marneierencio/cockpit-2dof/docs/PLANO_DE_CORTE.md

# Plano de corte dos tubos — revisão R3

> Gerado por `ferramentas/analisar.py`. Barras comerciais de 6 m, perda de serra de 3 mm por corte e 10 mm de
> esquadrejamento em cada ponta da barra. Distribuição pelo método *first-fit decreasing*.

**Como ler:** cada linha é uma barra. Corte as peças na ordem listada e marque cada peça com o código, que é o
mesmo do desenho e da lista de materiais.

Os comprimentos são os do eixo da peça no modelo, de face a face das peças que ela encontra. Para peças com corte
em ângulo (diagonais, pernas e bielas), o comprimento é medido no eixo e o ângulo está na lista de materiais.
Recomenda-se cortar com +2 mm e ajustar na montagem (gabarito).

## Tubo 10x20

Barras de 6 m: **1** · peças: 5 · comprimento líquido: 2,95 m · aproveitamento: 49 %

| Barra | Peças (código: comprimento mm) | Usado (mm) | Sobra (mm) |
|---|---|---|---|
| 1 | B-T12: 807, BC-T16: 564, BC-T17: 564, M-T13: 538, M-T12: 480 | 2965 | 3015 |

## Tubo 20x30

Barras de 6 m: **7** · peças: 91 · comprimento líquido: 41,27 m · aproveitamento: 98 %

| Barra | Peças (código: comprimento mm) | Usado (mm) | Sobra (mm) |
|---|---|---|---|
| 1 | B-T01: 2070, B-T02: 2070, A-T10: 1770 | 5916 | 64 |
| 2 | A-T16: 763, A-T20: 723, A-T14: 663, B-T03: 660, B-T11: 660, B-T04: 640, B-T05: 640, B-T06: 640, A-T18: 549 | 5962 | 18 |
| 3 | B-T07: 640, B-T08: 640, B-T09: 640, B-T10: 640, A-T19: 638, PE-T07: 596, PE-T09: 596, A-T15: 592, A-T01: 585, PE-T06: 370 | 5964 | 16 |
| 4 | A-T02: 585, A-T03: 585, A-T04: 585, A-T05: 585, A-T06: 585, A-T07: 585, A-T08: 585, A-T09: 585, A-T11: 570, A-T12: 570, A-T21: 116 | 5966 | 14 |
| 5 | M-T04: 510, M-T08: 510, M-T09: 510, M-T10: 510, M-T11: 510, M-T24: 510, M-T25: 510, BC-T13: 440, BC-T14: 440, BC-T15: 440, PE-T05: 440, BC-T01: 437, VO-T06: 152 | 5955 | 25 |
| 6 | BC-T02: 437, A-T17: 427, PE-T10: 400, PE-T16: 392, BC-T05: 390, BC-T06: 390, BC-T07: 390, BC-T08: 390, PE-T08: 370, BC-T09: 361, BC-T11: 361, PE-T11: 360, PE-T12: 360, PE-T15: 320, M-T19: 318, PE-T01: 230 | 5941 | 39 |
| 7 | BC-T03: 300, BC-T04: 300, BC-T20: 292, BC-T18: 287, BC-T19: 287, B-T17: 281, B-T18: 281, B-T19: 281, B-T20: 281, BC-T21: 280, PE-T03: 230, PE-T13: 230, B-T13: 210, B-T14: 210, B-T15: 210, B-T16: 210, PE-T14: 210, A-T13: 205, VO-T07: 152, M-T18: 152, BC-T10: 111, BC-T12: 111, B-T21: 110, B-T22: 110, PE-T02: 90, PE-T04: 90, M-T17: 88, BC-T22: 68, BC-T23: 68 | 5819 | 161 |

## Tubo 30x50

Barras de 6 m: **3** · peças: 19 · comprimento líquido: 14,87 m · aproveitamento: 83 %

| Barra | Peças (código: comprimento mm) | Usado (mm) | Sobra (mm) |
|---|---|---|---|
| 1 | M-T01: 1785, M-T02: 1785, M-T20: 1100, M-T22: 1100 | 5779 | 201 |
| 2 | M-T21: 1035, M-T23: 1035, PO-T01: 903, VO-T01: 728, VO-T02: 728, M-T03: 540, M-T05: 510, VO-T04: 463 | 5963 | 17 |
| 3 | M-T06: 510, M-T07: 510, VO-T03: 504, M-T16: 481, VO-T05: 463, M-T15: 420, M-T14: 271 | 3177 | 2803 |

## Compra de tubos

| Perfil | Barras de 6 m | Observação |
|---|---|---|
| 10x20 | 1 (+1 de reserva recomendada) | sobras ≥ 300 mm servem para gabaritos e calços |
| 20x30 | 7 (+1 de reserva recomendada) | sobras ≥ 300 mm servem para gabaritos e calços |
| 30x50 | 3 (+1 de reserva recomendada) | sobras ≥ 300 mm servem para gabaritos e calços |
