marneierencio/cockpit-2dof/imagens/preview_config_caminhao.png

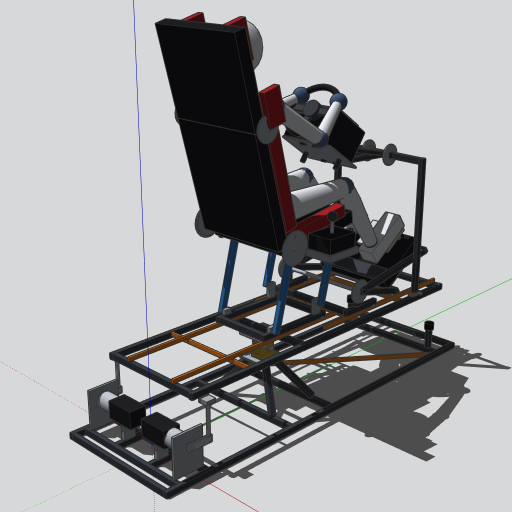
imagens/preview_config_caminhao.png
