marneierencio/cockpit-2dof/imagens/preview_config_F1.png

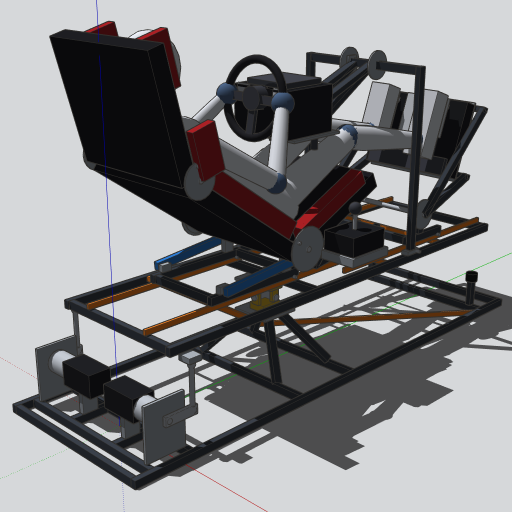
imagens/preview_config_F1.png
