marneierencio/cockpit-2dof/imagens/preview_transicao.png

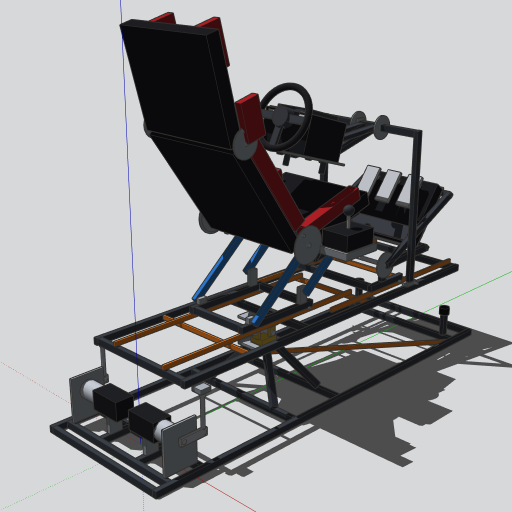
imagens/preview_transicao.png
