marneierencio/cockpit-2dof/docs/lista_de_materiais.csv

codigo | conjunto | tipo | descricao | perfil | dimensoes_mm | comprimento_corte_mm | corte | massa_kg | especificacao
B-T01 | Plataforma-base | Tubo | Longarina base E | 20x30 | 20x30 x 2070 | 2070 | reto | 1,838
B-T02 | Plataforma-base | Tubo | Longarina base D | 20x30 | 20x30 x 2070 | 2070 | reto | 1,838
B-T03 | Plataforma-base | Tubo | Travessa base y-190 | 20x30 | 20x30 x 660 | 660 | reto | 0,574
B-T04 | Plataforma-base | Tubo | Travessa base y40 | 20x30 | 20x30 x 640 | 640 | reto | 0,574
B-T05 | Plataforma-base | Tubo | Travessa base y300 | 20x30 | 20x30 x 640 | 640 | reto | 0,574
B-T06 | Plataforma-base | Tubo | Travessa base y560 | 20x30 | 20x30 x 640 | 640 | reto | 0,574
B-T07 | Plataforma-base | Tubo | Travessa base y650 | 20x30 | 20x30 x 640 | 640 | reto | 0,574
B-T08 | Plataforma-base | Tubo | Travessa base y840 | 20x30 | 20x30 x 640 | 640 | reto | 0,574
B-T09 | Plataforma-base | Tubo | Travessa base y1100 | 20x30 | 20x30 x 640 | 640 | reto | 0,574
B-T10 | Plataforma-base | Tubo | Travessa base y1700 | 20x30 | 20x30 x 640 | 640 | reto | 0,574
B-T11 | Plataforma-base | Tubo | Travessa base y1840 | 20x30 | 20x30 x 660 | 660 | reto | 0,574
B-T12 | Plataforma-base | Tubo | Diagonal base | 10x20 | 10x20 x 807 | 807 | angulo | 0,419
B-T13 | Plataforma-base | Tubo | Apoio motor E | 20x30 | 20x30 x 210 | 210 | reto | 0,188
B-T14 | Plataforma-base | Tubo | Longarina apoio chapa motor E | 20x30 | 20x30 x 210 | 210 | reto | 0,188
B-T15 | Plataforma-base | Tubo | Apoio motor D | 20x30 | 20x30 x 210 | 210 | reto | 0,188
B-T16 | Plataforma-base | Tubo | Longarina apoio chapa motor D | 20x30 | 20x30 x 210 | 210 | reto | 0,188
B-T17 | Plataforma-base | Tubo | Perna torre pivo | 20x30 | 20x30 x 281 | 281 | angulo | 0,237
B-T18 | Plataforma-base | Tubo | Perna torre pivo | 20x30 | 20x30 x 281 | 281 | angulo | 0,237
B-T19 | Plataforma-base | Tubo | Perna torre pivo | 20x30 | 20x30 x 281 | 281 | angulo | 0,237
B-T20 | Plataforma-base | Tubo | Perna torre pivo | 20x30 | 20x30 x 281 | 281 | angulo | 0,237
B-CH01 | Plataforma-base | Chapa/peça usinada | Chapa topo torre pivo 160x160x8 |  | 160 x 160 x 8 |  |  | 1,608
B-CO01 | Plataforma-base | Comprado | Garfo inferior cardan |  | 90 x 70 x 22 |  |  | 1,088 | Junta cardan (cruzeta com rolamentos de agulha), capacidade estatica >= 20 kN
B-CO02 | Plataforma-base | Comprado | Orelha garfo inferior |  | 35 x 32 x 14 |  |  | 0,123 | Junta cardan (cruzeta com rolamentos de agulha), capacidade estatica >= 20 kN
B-CO03 | Plataforma-base | Comprado | Orelha garfo inferior |  | 35 x 32 x 14 |  |  | 0,123 | Junta cardan (cruzeta com rolamentos de agulha), capacidade estatica >= 20 kN
B-CO04 | Plataforma-base | Comprado | Cruzeta eixo Y (rolagem) |  | Ø26 x 120 |  |  | 0,500 | Junta cardan (cruzeta com rolamentos de agulha), capacidade estatica >= 20 kN
B-CH02 | Plataforma-base | Chapa/peça usinada | Chapa suporte motor 6mm E |  | 177 x 120 x 6 |  |  | 1,000
B-CO05 | Plataforma-base | Comprado | Redutor planetario E |  | Ø84 x 95 |  |  | 3,000 | Redutor planetario 20:1 para NEMA 34 (flange 86 mm), torque nominal de saida >= 150 N.m
B-CO06 | Plataforma-base | Comprado | Motor de passo NEMA 34 E |  | 150 x 86 x 86 |  |  | 5,500 | Motor de passo NEMA 34 12 N.m em malha fechada (ex.: 86HSE12N) + driver
B-CH03 | Plataforma-base | Chapa/peça usinada | Calco motor E |  | 87 x 60 x 20 |  |  | 0,820
B-PI01 | Plataforma-base | Pino | Eixo saida redutor E |  | Ø20 x 23 |  |  | 0,057
B-CH04 | Plataforma-base | Chapa/peça usinada | Braco manivela 10mm E |  | 150 x 50 x 10 |  |  | 0,589
B-CO07 | Plataforma-base | Comprado | Terminal rotular inferior E |  |  |  |  | 0,072 | Terminal rotular M16 (rod end)
B-CH05 | Plataforma-base | Chapa/peça usinada | Chapa suporte motor 6mm D |  | 177 x 120 x 6 |  |  | 1,000
B-CO08 | Plataforma-base | Comprado | Redutor planetario D |  | Ø84 x 95 |  |  | 3,000 | Redutor planetario 20:1 para NEMA 34 (flange 86 mm), torque nominal de saida >= 150 N.m
B-CO09 | Plataforma-base | Comprado | Motor de passo NEMA 34 D |  | 150 x 86 x 86 |  |  | 5,500 | Motor de passo NEMA 34 12 N.m em malha fechada (ex.: 86HSE12N) + driver
B-CH06 | Plataforma-base | Chapa/peça usinada | Calco motor D |  | 87 x 60 x 20 |  |  | 0,820
B-PI02 | Plataforma-base | Pino | Eixo saida redutor D |  | Ø20 x 23 |  |  | 0,057
B-CH07 | Plataforma-base | Chapa/peça usinada | Braco manivela 10mm D |  | 150 x 50 x 10 |  |  | 0,589
B-CO10 | Plataforma-base | Comprado | Terminal rotular inferior D |  |  |  |  | 0,072 | Terminal rotular M16 (rod end)
B-T21 | Plataforma-base | Tubo | Coluna batente E | 20x30 | 20x30 x 110 | 110 | reto | 0,099
B-CO11 | Plataforma-base | Comprado | Batente borracha E |  | Ø48 x 35 |  |  | 0,100 | Batente de borracha Ø48 x 35
B-T22 | Plataforma-base | Tubo | Coluna batente D | 20x30 | 20x30 x 110 | 110 | reto | 0,099
B-CO12 | Plataforma-base | Comprado | Batente borracha D |  | Ø48 x 35 |  |  | 0,100 | Batente de borracha Ø48 x 35
M-T01 | Chassi móvel | Tubo | Longarina principal E | 30x50 | 30x50 x 1785 | 1785 | reto | 2,588
M-T02 | Chassi móvel | Tubo | Longarina principal D | 30x50 | 30x50 x 1785 | 1785 | reto | 2,588
M-T03 | Chassi móvel | Tubo | Travessa chassi y25 | 30x50 | 30x50 x 540 | 540 | reto | 0,746
M-T04 | Chassi móvel | Tubo | Travessa chassi y300 | 20x30 | 20x30 x 510 | 510 | reto | 0,457
M-T05 | Chassi móvel | Tubo | Travessa chassi y650 | 30x50 | 30x50 x 510 | 510 | reto | 0,746
M-T06 | Chassi móvel | Tubo | Travessa chassi y700 | 30x50 | 30x50 x 510 | 510 | reto | 0,746
M-T07 | Chassi móvel | Tubo | Travessa chassi y750 | 30x50 | 30x50 x 510 | 510 | reto | 0,746
M-T08 | Chassi móvel | Tubo | Travessa chassi y900 | 20x30 | 20x30 x 510 | 510 | reto | 0,457
M-T09 | Chassi móvel | Tubo | Travessa chassi y1100 | 20x30 | 20x30 x 510 | 510 | reto | 0,457
M-T10 | Chassi móvel | Tubo | Travessa chassi y1450 | 20x30 | 20x30 x 510 | 510 | reto | 0,457
M-T11 | Chassi móvel | Tubo | Travessa chassi y1765 | 20x30 | 20x30 x 510 | 510 | reto | 0,457
M-T12 | Chassi móvel | Tubo | Diagonal piso y25-300 | 10x20 | 10x20 x 480 | 480 | angulo | 0,249
M-T13 | Chassi móvel | Tubo | Diagonal piso y1100-1450 | 10x20 | 10x20 x 538 | 538 | angulo | 0,279
M-CH01 | Chassi móvel | Chapa/peça usinada | Chapa pivo 300x140x8 |  | 300 x 140 x 8 |  |  | 2,638
M-T14 | Chassi móvel | Tubo | Banzo inferior soleira E y60-300 | 30x50 | 30x50 x 271 | 271 | angulo | 0,322
M-T15 | Chassi móvel | Tubo | Banzo inferior soleira E y300-700 | 30x50 | 30x50 x 420 | 420 | angulo | 0,595
M-T16 | Chassi móvel | Tubo | Banzo inferior soleira E y700-1132 | 30x50 | 30x50 x 481 | 481 | angulo | 0,614
M-T17 | Chassi móvel | Tubo | Montante soleira E y324 | 20x30 | 20x30 x 88 | 88 | reto | 0,076
M-T18 | Chassi móvel | Tubo | Montante soleira E y670 | 20x30 | 20x30 x 152 | 152 | reto | 0,134
M-T19 | Chassi móvel | Tubo | Diagonal soleira E y324-670 | 20x30 | 20x30 x 318 | 318 | angulo | 0,285
M-CH02 | Chassi móvel | Chapa/peça usinada | Suporte haste traseira E |  | 50 x 45 x 20 |  |  | 0,353
M-CO01 | Chassi móvel | Comprado | Haste ligacao E |  | Ø16 x 124 |  |  | 0,196 | Barra rosqueada M16 + porcas (entre rotulas)
M-CO02 | Chassi móvel | Comprado | Terminal rotular superior E |  |  |  |  | 0,072 | Terminal rotular M16 (rod end)
M-CH03 | Chassi móvel | Chapa/peça usinada | Suporte haste traseira D |  | 50 x 45 x 20 |  |  | 0,353
M-CO03 | Chassi móvel | Comprado | Haste ligacao D |  | Ø16 x 124 |  |  | 0,196 | Barra rosqueada M16 + porcas (entre rotulas)
M-CO04 | Chassi móvel | Comprado | Terminal rotular superior D |  |  |  |  | 0,072 | Terminal rotular M16 (rod end)
M-CO05 | Chassi móvel | Comprado | Garfo superior cardan |  | 120 x 60 x 22 |  |  | 1,243 | Junta cardan (cruzeta com rolamentos de agulha), capacidade estatica >= 20 kN
M-CO06 | Chassi móvel | Comprado | Orelha garfo superior |  | 48 x 32 x 14 |  |  | 0,169 | Junta cardan (cruzeta com rolamentos de agulha), capacidade estatica >= 20 kN
M-CO07 | Chassi móvel | Comprado | Orelha garfo superior |  | 48 x 32 x 14 |  |  | 0,169 | Junta cardan (cruzeta com rolamentos de agulha), capacidade estatica >= 20 kN
M-CO08 | Chassi móvel | Comprado | Cruzeta eixo X (arfagem) |  | Ø26 x 120 |  |  | 0,500 | Junta cardan (cruzeta com rolamentos de agulha), capacidade estatica >= 20 kN
M-T20 | Chassi móvel | Tubo | Trilho banco E | 30x50 | 30x50 x 1100 | 1100 | reto | 1,608
M-T21 | Chassi móvel | Tubo | Trilho pedaleira E | 30x50 | 30x50 x 1035 | 1035 | reto | 1,513
M-T22 | Chassi móvel | Tubo | Trilho banco D | 30x50 | 30x50 x 1100 | 1100 | reto | 1,608
M-T23 | Chassi móvel | Tubo | Trilho pedaleira D | 30x50 | 30x50 x 1035 | 1035 | reto | 1,513
BC-T01 | Banco | Tubo | Longarina carro banco E | 20x30 | 20x30 x 437 | 437 | reto | 0,373
BC-CH01 | Banco | Chapa/peça usinada | Mancal biela tras E |  | 40 x 27 x 20 |  |  | 0,170
BC-PI01 | Banco | Pino | Pino mancal biela tras E |  | Ø16 x 30 |  |  | 0,047 | Pino aco 1045 Ø16 x 30 mm + 2 travas (anel elastico) + 2 buchas soldadas
BC-CH02 | Banco | Chapa/peça usinada | Mancal biela diant E |  | 75 x 40 x 20 |  |  | 0,474
BC-PI02 | Banco | Pino | Pino mancal biela diant E |  | Ø16 x 30 |  |  | 0,047 | Pino aco 1045 Ø16 x 30 mm + 2 travas (anel elastico) + 2 buchas soldadas
BC-PI03 | Banco | Pino | Pino indexador trilho banco E |  | Ø12 x 60 |  |  | 0,053 | Pino de trava rapida (ball lock) Ø12 x 60 mm com argola
BC-T02 | Banco | Tubo | Longarina carro banco D | 20x30 | 20x30 x 437 | 437 | reto | 0,373
BC-CH03 | Banco | Chapa/peça usinada | Mancal biela tras D |  | 40 x 27 x 20 |  |  | 0,170
BC-PI04 | Banco | Pino | Pino mancal biela tras D |  | Ø16 x 30 |  |  | 0,047 | Pino aco 1045 Ø16 x 30 mm + 2 travas (anel elastico) + 2 buchas soldadas
BC-CH04 | Banco | Chapa/peça usinada | Mancal biela diant D |  | 75 x 40 x 20 |  |  | 0,474
BC-PI05 | Banco | Pino | Pino mancal biela diant D |  | Ø16 x 30 |  |  | 0,047 | Pino aco 1045 Ø16 x 30 mm + 2 travas (anel elastico) + 2 buchas soldadas
BC-PI06 | Banco | Pino | Pino indexador trilho banco D |  | Ø12 x 60 |  |  | 0,053 | Pino de trava rapida (ball lock) Ø12 x 60 mm com argola
BC-T03 | Banco | Tubo | Travessa carro banco tras | 20x30 | 20x30 x 300 | 300 | reto | 0,251
BC-T04 | Banco | Tubo | Travessa carro banco diant | 20x30 | 20x30 x 300 | 300 | reto | 0,251
BC-T05 | Banco | Tubo | Biela banco E Tras | 20x30 | 20x30 x 390 | 390 | reto | 0,350
BC-T06 | Banco | Tubo | Biela banco D Tras | 20x30 | 20x30 x 390 | 390 | reto | 0,350
BC-T07 | Banco | Tubo | Biela banco E Diant | 20x30 | 20x30 x 390 | 390 | reto | 0,350
BC-T08 | Banco | Tubo | Biela banco D Diant | 20x30 | 20x30 x 390 | 390 | reto | 0,350
BC-T09 | Banco | Tubo | Longarina subchassi E | 20x30 | 20x30 x 361 | 361 | reto | 0,323
BC-T10 | Banco | Tubo | Montante articulacao E | 20x30 | 20x30 x 111 | 111 | angulo | 0,089
BC-PI07 | Banco | Pino | Pino biela subchassi E |  | Ø16 x 90 |  |  | 0,142 | Pino aco 1045 Ø16 x 90 mm + 2 travas (anel elastico) + 2 buchas soldadas
BC-PI08 | Banco | Pino | Pino biela subchassi E |  | Ø16 x 90 |  |  | 0,142 | Pino aco 1045 Ø16 x 90 mm + 2 travas (anel elastico) + 2 buchas soldadas
BC-T11 | Banco | Tubo | Longarina subchassi D | 20x30 | 20x30 x 361 | 361 | reto | 0,323
BC-T12 | Banco | Tubo | Montante articulacao D | 20x30 | 20x30 x 111 | 111 | angulo | 0,089
BC-PI09 | Banco | Pino | Pino biela subchassi D |  | Ø16 x 90 |  |  | 0,142 | Pino aco 1045 Ø16 x 90 mm + 2 travas (anel elastico) + 2 buchas soldadas
BC-PI10 | Banco | Pino | Pino biela subchassi D |  | Ø16 x 90 |  |  | 0,142 | Pino aco 1045 Ø16 x 90 mm + 2 travas (anel elastico) + 2 buchas soldadas
BC-PI11 | Banco | Pino | Eixo articulacao assento/encosto |  | Ø20 x 580 |  |  | 1,430 | Pino aco 1045 Ø20 x 580 mm + 2 travas (anel elastico) + 2 buchas soldadas
BC-CO01 | Banco | Comprado | Calco borracha apoio F1 tras E |  | Ø28 x 78 |  |  | 0,050 | Calco de borracha Ø28 com parafuso (apoio do subchassi em F1)
BC-CO02 | Banco | Comprado | Calco borracha apoio F1 diant E |  | Ø28 x 117 |  |  | 0,050 | Calco de borracha Ø28 com parafuso (apoio do subchassi em F1)
BC-CO03 | Banco | Comprado | Calco borracha apoio F1 tras D |  | Ø28 x 78 |  |  | 0,050 | Calco de borracha Ø28 com parafuso (apoio do subchassi em F1)
BC-CO04 | Banco | Comprado | Calco borracha apoio F1 diant D |  | Ø28 x 117 |  |  | 0,050 | Calco de borracha Ø28 com parafuso (apoio do subchassi em F1)
BC-ES01 | Banco | Estofado | Assento estofado 480x440x60 |  | 480 x 440 x 60 |  |  | 3,000 | Assento estofado sobre base de compensado/aco
BC-T13 | Banco | Tubo | Espinha assento | 20x30 | 20x30 x 440 | 440 | reto | 0,395
BC-ES02 | Banco | Estofado | Aba assento E |  | 350 x 55 x 50 |  |  | 0,400
BC-ES03 | Banco | Estofado | Aba assento D |  | 350 x 55 x 50 |  |  | 0,400
BC-ES04 | Banco | Estofado | Encosto lombar 480x563x60 |  | 563 x 480 x 60 |  |  | 3,500 | Encosto estofado sobre base de compensado/aco
BC-T14 | Banco | Tubo | Espinha encosto | 20x30 | 20x30 x 440 | 440 | reto | 0,395
BC-ES05 | Banco | Estofado | Aba encosto E |  | 463 x 65 x 50 |  |  | 0,500
BC-ES06 | Banco | Estofado | Aba encosto D |  | 463 x 65 x 50 |  |  | 0,500
BC-PI12 | Banco | Pino | Eixo articulacao apoio superior |  | Ø18 x 524 |  |  | 1,047 | Pino aco 1045 Ø18 x 524 mm + 2 travas (anel elastico) + 2 buchas soldadas
BC-ES07 | Banco | Estofado | Apoio ombros/cabeca 480x430x60 |  | 480 x 430 x 60 |  |  | 2,500 | Apoio estofado sobre base de compensado/aco
BC-T15 | Banco | Tubo | Espinha apoio superior | 20x30 | 20x30 x 440 | 440 | reto | 0,395
BC-ES08 | Banco | Estofado | Aba ombro E |  | 160 x 90 x 30 |  |  | 0,400
BC-ES09 | Banco | Estofado | Aba cabeca E |  | 180 x 100 x 30 |  |  | 0,300
BC-ES10 | Banco | Estofado | Aba ombro D |  | 160 x 90 x 30 |  |  | 0,400
BC-ES11 | Banco | Estofado | Aba cabeca D |  | 180 x 100 x 30 |  |  | 0,300
BC-T16 | Banco | Tubo | Tirante paralelo apoio superior E | 10x20 | 10x20 x 564 | 564 | reto | 0,293
BC-CH05 | Banco | Chapa/peça usinada | Orelha tirante subchassi E |  | 52 x 27 x 8 |  |  | 0,089
BC-CH06 | Banco | Chapa/peça usinada | Orelha tirante apoio E |  | 40 x 30 x 8 |  |  | 0,075
BC-PI13 | Banco | Pino | Pino tirante inferior E |  | Ø12 x 24 |  |  | 0,021 | Pino aco 1045 Ø12 x 24 mm + 2 travas (anel elastico) + 2 buchas soldadas
BC-PI14 | Banco | Pino | Pino tirante superior E |  | Ø12 x 24 |  |  | 0,021 | Pino aco 1045 Ø12 x 24 mm + 2 travas (anel elastico) + 2 buchas soldadas
BC-T17 | Banco | Tubo | Tirante paralelo apoio superior D | 10x20 | 10x20 x 564 | 564 | reto | 0,293
BC-CH07 | Banco | Chapa/peça usinada | Orelha tirante subchassi D |  | 52 x 27 x 8 |  |  | 0,089
BC-CH08 | Banco | Chapa/peça usinada | Orelha tirante apoio D |  | 40 x 30 x 8 |  |  | 0,075
BC-PI15 | Banco | Pino | Pino tirante inferior D |  | Ø12 x 24 |  |  | 0,021 | Pino aco 1045 Ø12 x 24 mm + 2 travas (anel elastico) + 2 buchas soldadas
BC-PI16 | Banco | Pino | Pino tirante superior D |  | Ø12 x 24 |  |  | 0,021 | Pino aco 1045 Ø12 x 24 mm + 2 travas (anel elastico) + 2 buchas soldadas
BC-CH09 | Banco | Chapa/peça usinada | Alavanca encosto E (chapa 12x70) |  | 175 x 70 x 12 |  |  | 1,154
BC-T18 | Banco | Tubo | Haste comando encosto E | 20x30 | 20x30 x 287 | 287 | reto | 0,257
BC-CH10 | Banco | Chapa/peça usinada | Suporte haste encosto E |  | 40 x 30 x 12 |  |  | 0,115
BC-CH11 | Banco | Chapa/peça usinada | Alavanca encosto D (chapa 12x70) |  | 175 x 70 x 12 |  |  | 1,154
BC-T19 | Banco | Tubo | Haste comando encosto D | 20x30 | 20x30 x 287 | 287 | reto | 0,257
BC-CH12 | Banco | Chapa/peça usinada | Suporte haste encosto D |  | 40 x 30 x 12 |  |  | 0,115
BC-CH13 | Banco | Chapa/peça usinada | Orelha haste assento (chapa 12) |  | 95 x 70 x 12 |  |  | 0,626
BC-T20 | Banco | Tubo | Haste comando assento | 20x30 | 20x30 x 292 | 292 | reto | 0,261
BC-CH14 | Banco | Chapa/peça usinada | Suporte haste assento |  | 40 x 37 x 12 |  |  | 0,140
BC-T21 | Banco | Tubo | Travessa carro banco haste encosto | 20x30 | 20x30 x 280 | 280 | reto | 0,251
M-T24 | Chassi móvel | Tubo | Travessa suporte tirante arrasto | 20x30 | 20x30 x 510 | 510 | reto | 0,457
BC-T22 | Banco | Tubo | Tirante de arrasto do carro E | 20x30 | 20x30 x 68 | 68 | reto | 0,061
BC-CH15 | Banco | Chapa/peça usinada | Suporte tirante arrasto E |  | 128 x 24 x 20 |  |  | 0,481
BC-PI17 | Banco | Pino | Pino tirante arrasto na biela E |  | Ø12 x 24 |  |  | 0,021 | Pino aco 1045 Ø12 x 24 mm + 2 travas (anel elastico) + 2 buchas soldadas
BC-T23 | Banco | Tubo | Tirante de arrasto do carro D | 20x30 | 20x30 x 68 | 68 | reto | 0,061
BC-CH16 | Banco | Chapa/peça usinada | Suporte tirante arrasto D |  | 128 x 24 x 20 |  |  | 0,481
BC-PI18 | Banco | Pino | Pino tirante arrasto na biela D |  | Ø12 x 24 |  |  | 0,021 | Pino aco 1045 Ø12 x 24 mm + 2 travas (anel elastico) + 2 buchas soldadas
PE-T01 | Pedaleira | Tubo | Longarina carro pedaleira E | 20x30 | 20x30 x 230 | 230 | reto | 0,206
PE-T02 | Pedaleira | Tubo | Torre pivo pedaleira E | 20x30 | 20x30 x 90 | 90 | reto | 0,081
PE-PI01 | Pedaleira | Pino | Pino indexador trilho pedaleira E |  | Ø12 x 60 |  |  | 0,053 | Pino de trava rapida (ball lock) Ø12 x 60 mm com argola
PE-T03 | Pedaleira | Tubo | Longarina carro pedaleira D | 20x30 | 20x30 x 230 | 230 | reto | 0,206
PE-T04 | Pedaleira | Tubo | Torre pivo pedaleira D | 20x30 | 20x30 x 90 | 90 | reto | 0,081
PE-PI02 | Pedaleira | Pino | Pino indexador trilho pedaleira D |  | Ø12 x 60 |  |  | 0,053 | Pino de trava rapida (ball lock) Ø12 x 60 mm com argola
PE-T05 | Pedaleira | Tubo | Travessa carro pedaleira | 20x30 | 20x30 x 440 | 440 | reto | 0,395
PE-PI03 | Pedaleira | Pino | Eixo pivo pedaleira |  | Ø18 x 490 |  |  | 0,979 | Pino aco 1045 Ø18 x 490 mm + 2 travas (anel elastico) + 2 buchas soldadas
PE-CH01 | Pedaleira | Chapa/peça usinada | Chapa fixacao pedais 400x331x2 |  | 400 x 331 x 2 |  |  | 2,079
PE-CO01 | Pedaleira | Comprado | Pedais G920 (carcaca) |  | 428 x 311 x 55 |  |  | 2,400 | Logitech G920 - pedais (428,5 x 311 x 167 mm, 3,1 kg)
PE-CO02 | Pedaleira | Comprado | Pedais G920 (apoio calcanhar) |  | 380 x 70 x 20 |  |  | 0,100 | Logitech G920 - pedais (428,5 x 311 x 167 mm, 3,1 kg)
PE-CO03 | Pedaleira | Comprado | Pedais G920 (pedal embreagem) |  | 160 x 74 x 16 |  |  | 0,200 | Logitech G920 - pedais (428,5 x 311 x 167 mm, 3,1 kg)
PE-CO04 | Pedaleira | Comprado | Pedais G920 (pedal freio) |  | 160 x 74 x 16 |  |  | 0,200 | Logitech G920 - pedais (428,5 x 311 x 167 mm, 3,1 kg)
PE-CO05 | Pedaleira | Comprado | Pedais G920 (pedal acelerador) |  | 160 x 74 x 16 |  |  | 0,200 | Logitech G920 - pedais (428,5 x 311 x 167 mm, 3,1 kg)
PE-T06 | Pedaleira | Tubo | Braco pedaleira inferior E | 20x30 | 20x30 x 370 | 370 | angulo | 0,253
PE-T07 | Pedaleira | Tubo | Braco pedaleira superior E | 20x30 | 20x30 x 596 | 596 | angulo | 0,471
PE-T08 | Pedaleira | Tubo | Braco pedaleira inferior D | 20x30 | 20x30 x 370 | 370 | angulo | 0,253
PE-T09 | Pedaleira | Tubo | Braco pedaleira superior D | 20x30 | 20x30 x 596 | 596 | angulo | 0,471
PE-T10 | Pedaleira | Tubo | Travessa pedaleira inferior | 20x30 | 20x30 x 400 | 400 | reto | 0,359
PE-T11 | Pedaleira | Tubo | Travessa pedaleira superior | 20x30 | 20x30 x 360 | 360 | reto | 0,323
PE-T12 | Pedaleira | Tubo | Tubo de torcao pedaleira | 20x30 | 20x30 x 360 | 360 | reto | 0,323
PE-T13 | Pedaleira | Tubo | Alavanca haste pedaleira | 20x30 | 20x30 x 230 | 230 | reto | 0,206
PE-T14 | Pedaleira | Tubo | Haste comando pedaleira | 20x30 | 20x30 x 210 | 210 | reto | 0,188
PE-PI04 | Pedaleira | Pino | Pino haste/alavanca pedaleira |  | Ø16 x 50 |  |  | 0,079 | Pino aco 1045 Ø16 x 50 mm + 2 travas (anel elastico) + 2 buchas soldadas
PE-T15 | Pedaleira | Tubo | Poste suporte haste pedaleira | 20x30 | 20x30 x 320 | 320 | reto | 0,287
PE-PI05 | Pedaleira | Pino | Pino haste pedaleira no poste |  | Ø16 x 48 |  |  | 0,076 | Pino aco 1045 Ø16 x 48 mm + 2 travas (anel elastico) + 2 buchas soldadas
PE-T16 | Pedaleira | Tubo | Mao-francesa poste haste pedaleira | 20x30 | 20x30 x 392 | 392 | angulo | 0,324
M-T25 | Chassi móvel | Tubo | Travessa suporte haste pedaleira | 20x30 | 20x30 x 510 | 510 | reto | 0,457
VO-CH01 | Volante | Chapa/peça usinada | Patim trilho mastro E |  | 80 x 30 x 12 |  |  | 0,226
VO-T01 | Volante | Tubo | Coluna volante E | 30x50 | 30x50 x 728 | 728 | reto | 1,064
VO-CH02 | Volante | Chapa/peça usinada | Guia superior coluna/anel E |  | 80 x 50 x 6 |  |  | 0,188
VO-CH03 | Volante | Chapa/peça usinada | Guia inferior coluna/anel E |  | 80 x 50 x 6 |  |  | 0,188
VO-PI01 | Volante | Pino | Pino indexador mastro E |  | Ø12 x 24 |  |  | 0,021 | Pino de trava rapida (ball lock) Ø12 x 24 mm com argola
VO-CO01 | Volante | Comprado | Mancal tubo torcao E |  | Ø60 x 30 |  |  | 0,400 | Mancal flangeado para eixo Ø25
VO-CH04 | Volante | Chapa/peça usinada | Patim trilho mastro D |  | 80 x 30 x 12 |  |  | 0,226
VO-T02 | Volante | Tubo | Coluna volante D | 30x50 | 30x50 x 728 | 728 | reto | 1,064
VO-CH05 | Volante | Chapa/peça usinada | Guia superior coluna/anel D |  | 80 x 50 x 6 |  |  | 0,188
VO-CH06 | Volante | Chapa/peça usinada | Guia inferior coluna/anel D |  | 80 x 50 x 6 |  |  | 0,188
VO-PI02 | Volante | Pino | Pino indexador mastro D |  | Ø12 x 24 |  |  | 0,021 | Pino de trava rapida (ball lock) Ø12 x 24 mm com argola
VO-CO02 | Volante | Comprado | Mancal tubo torcao D |  | Ø60 x 30 |  |  | 0,400 | Mancal flangeado para eixo Ø25
VO-T03 | Volante | Tubo | Tubo de torcao volante | 30x50 | 30x50 x 504 | 504 | reto | 0,737
VO-PI03 | Volante | Pino | Eixo pivo volante |  | Ø25 x 600 |  |  | 2,312
VO-CH07 | Volante | Chapa/peça usinada | Mesa volante 300x240x3 |  | 300 x 240 x 3 |  |  | 1,696
VO-CO03 | Volante | Comprado | Volante G920 (base) |  | 260 x 232 x 170 |  |  | 1,600 | Logitech G920 - volante (270 x 260 x 278 mm, 2,25 kg)
VO-CO04 | Volante | Comprado | Volante G920 (tampa) |  | 190 x 180 x 20 |  |  | 0,050 | Logitech G920 - volante (270 x 260 x 278 mm, 2,25 kg)
VO-CO05 | Volante | Comprado | Volante G920 (aro) |  |  |  |  | 0,500 | Logitech G920 - volante (270 x 260 x 278 mm, 2,25 kg)
VO-CO06 | Volante | Comprado | Volante G920 (cubo) |  | Ø84 x 58 |  |  | 0,100 | Logitech G920 - volante (270 x 260 x 278 mm, 2,25 kg)
VO-T04 | Volante | Tubo | Braco volante E | 30x50 | 30x50 x 463 | 463 | angulo | 0,667
VO-T05 | Volante | Tubo | Braco volante D | 30x50 | 30x50 x 463 | 463 | angulo | 0,667
VO-T06 | Volante | Tubo | Alavanca came volante E | 20x30 | 20x30 x 152 | 152 | reto | 0,136
VO-PI04 | Volante | Pino | Pino seguidor came volante E |  | Ø12 x 24 |  |  | 0,021 | Pino aco 1045 Ø12 x 24 mm + 2 travas (anel elastico) + 2 buchas soldadas
VO-CH08 | Volante | Chapa/peça usinada | Chapa came volante 4mm E |  | 235 x 140 x 4 |  |  | 1,036
VO-T07 | Volante | Tubo | Alavanca came volante D | 20x30 | 20x30 x 152 | 152 | reto | 0,136
VO-PI05 | Volante | Pino | Pino seguidor came volante D |  | Ø12 x 24 |  |  | 0,021 | Pino aco 1045 Ø12 x 24 mm + 2 travas (anel elastico) + 2 buchas soldadas
VO-CH09 | Volante | Chapa/peça usinada | Chapa came volante 4mm D |  | 235 x 140 x 4 |  |  | 1,036
A-T01 | Anel estrutural | Tubo | Coluna anel D y25 | 20x30 | 20x30 x 585 | 585 | reto | 0,525
A-T02 | Anel estrutural | Tubo | Coluna anel D y400 | 20x30 | 20x30 x 585 | 585 | reto | 0,525
A-T03 | Anel estrutural | Tubo | Coluna anel D y1000 | 20x30 | 20x30 x 585 | 585 | reto | 0,525
A-T04 | Anel estrutural | Tubo | Coluna anel D y1765 | 20x30 | 20x30 x 585 | 585 | reto | 0,525
A-T05 | Anel estrutural | Tubo | Coluna anel E y25 | 20x30 | 20x30 x 585 | 585 | reto | 0,525
A-T06 | Anel estrutural | Tubo | Coluna anel E y200 | 20x30 | 20x30 x 585 | 585 | reto | 0,525
A-T07 | Anel estrutural | Tubo | Coluna anel E y1132 | 20x30 | 20x30 x 585 | 585 | reto | 0,525
A-T08 | Anel estrutural | Tubo | Coluna anel E y1450 | 20x30 | 20x30 x 585 | 585 | reto | 0,525
A-T09 | Anel estrutural | Tubo | Coluna anel E y1765 | 20x30 | 20x30 x 585 | 585 | reto | 0,525
A-T10 | Anel estrutural | Tubo | Anel lado D | 20x30 | 20x30 x 1770 | 1770 | reto | 1,587
A-T11 | Anel estrutural | Tubo | Travessa traseira rebaixada | 20x30 | 20x30 x 570 | 570 | reto | 0,511
A-T12 | Anel estrutural | Tubo | Anel dianteiro | 20x30 | 20x30 x 570 | 570 | reto | 0,511
A-T13 | Anel estrutural | Tubo | Anel lado E traseiro | 20x30 | 20x30 x 205 | 205 | reto | 0,184
A-T14 | Anel estrutural | Tubo | Anel lado E dianteiro | 20x30 | 20x30 x 663 | 663 | reto | 0,594
A-T15 | Anel estrutural | Tubo | Diagonal anel D y25-400 | 20x30 | 20x30 x 592 | 592 | angulo | 0,530
A-T16 | Anel estrutural | Tubo | Diagonal anel D y400-1000 | 20x30 | 20x30 x 763 | 763 | angulo | 0,684
A-T17 | Anel estrutural | Tubo | Diagonal anel E y25-200 | 20x30 | 20x30 x 427 | 427 | angulo | 0,383
A-T18 | Anel estrutural | Tubo | Diagonal anel E y1132-1450 | 20x30 | 20x30 x 549 | 549 | angulo | 0,492
A-T19 | Anel estrutural | Tubo | Diagonal quadro traseiro | 20x30 | 20x30 x 638 | 638 | angulo | 0,571
A-T20 | Anel estrutural | Tubo | Diagonal quadro dianteiro | 20x30 | 20x30 x 723 | 723 | angulo | 0,648
A-CH01 | Anel estrutural | Chapa/peça usinada | Chapa suporte cambio 190x140x6 |  | 190 x 150 x 6 |  |  | 1,342
A-T21 | Anel estrutural | Tubo | Mao-francesa suporte cambio | 20x30 | 20x30 x 116 | 116 | angulo | 0,103
A-CO01 | Anel estrutural | Comprado | Cambio (carcaca) |  | 165 x 130 x 70 |  |  | 0,700 | Logitech Driving Force Shifter (130 x 165 x 167 mm, estimado)
A-CO02 | Anel estrutural | Comprado | Cambio (alavanca) |  | Ø14 x 72 |  |  | 0,100 | Logitech Driving Force Shifter (130 x 165 x 167 mm, estimado)
A-CO03 | Anel estrutural | Comprado | Cambio (manopla) |  |  |  |  | 0,100 | Logitech Driving Force Shifter (130 x 165 x 167 mm, estimado)
PO-T01 | Barra da porta | Tubo | Barra da porta | 30x50 | 30x50 x 903 | 903 | reto | 1,319
PO-PI01 | Barra da porta | Pino | Eixo dobradica porta |  | Ø16 x 50 |  |  | 0,079 | Pino aco 1045 Ø16 x 50 mm + 2 travas (anel elastico) + 2 buchas soldadas
PO-CH01 | Barra da porta | Chapa/peça usinada | Orelhas dobradica porta |  | 44 x 40 x 30 |  |  | 0,414
PO-CH02 | Barra da porta | Chapa/peça usinada | Fecho da porta - orelha externa |  | 40 x 35 x 6 |  |  | 0,066
PO-CH03 | Barra da porta | Chapa/peça usinada | Fecho da porta - orelha interna |  | 40 x 35 x 6 |  |  | 0,066
PO-CH04 | Barra da porta | Chapa/peça usinada | Fecho da porta - apoio |  | 35 x 32 x 6 |  |  | 0,053
PO-PI02 | Barra da porta | Pino | Trava rapida da porta |  | Ø10 x 48 |  |  | 0,050 | Pino de trava rapida (ball lock) Ø10 x 50
MO-CH01 | Molas de centragem | Chapa/peça usinada | Olhal base mola arfagem tras |  | 30 x 30 x 8 |  |  | 0,057
MO-CH02 | Molas de centragem | Chapa/peça usinada | Olhal chassi mola arfagem tras |  | 30 x 30 x 8 |  |  | 0,057
MO-CO01 | Molas de centragem | Comprado | Mola de tracao arfagem tras |  | Ø40 x 280 |  |  | 0,600 | Mola de tracao com olhais (rigidez/pre-carga em CALCULOS.md)
MO-CH03 | Molas de centragem | Chapa/peça usinada | Olhal base mola arfagem diant |  | 30 x 30 x 8 |  |  | 0,057
MO-CH04 | Molas de centragem | Chapa/peça usinada | Olhal chassi mola arfagem diant |  | 30 x 30 x 8 |  |  | 0,057
MO-CO02 | Molas de centragem | Comprado | Mola de tracao arfagem diant |  | Ø40 x 280 |  |  | 0,600 | Mola de tracao com olhais (rigidez/pre-carga em CALCULOS.md)
MO-CH05 | Molas de centragem | Chapa/peça usinada | Olhal base mola rolagem E |  | 30 x 30 x 8 |  |  | 0,057
MO-CH06 | Molas de centragem | Chapa/peça usinada | Olhal chassi mola rolagem E |  | 30 x 30 x 8 |  |  | 0,057
MO-CO03 | Molas de centragem | Comprado | Mola de tracao rolagem E |  | Ø40 x 260 |  |  | 0,600 | Mola de tracao com olhais (rigidez/pre-carga em CALCULOS.md)
MO-CH07 | Molas de centragem | Chapa/peça usinada | Olhal base mola rolagem D |  | 30 x 30 x 8 |  |  | 0,057
MO-CH08 | Molas de centragem | Chapa/peça usinada | Olhal chassi mola rolagem D |  | 30 x 30 x 8 |  |  | 0,057
MO-CO04 | Molas de centragem | Comprado | Mola de tracao rolagem D |  | Ø40 x 260 |  |  | 0,600 | Mola de tracao com olhais (rigidez/pre-carga em CALCULOS.md)
