marneierencio/cockpit-2dof/docs/LISTA_DE_MATERIAIS.md

# Lista de materiais — revisão R3

> Gerada por `ferramentas/analisar.py` a partir do modelo. Cada código abaixo é o nome da peça no SketchUp
> (janela *Outliner*: `<código> <descrição>`), então qualquer peça do desenho é localizada pelo código.

**Códigos:** `<conjunto>-<tipo><nº>`.

- Conjuntos: B base, M chassi móvel, A anel, PO barra da porta, BC banco, PE pedaleira, VO volante, MO molas.
- Tipos: T tubo, CH chapa/peça, PI pino, CO comprado, ES estofado.

## Resumo

| Tipo | Itens | Massa (kg) |
|---|---|---|
| Tubo | 115 | 59,4 |
| Chapa/peça usinada | 49 | 25,1 |
| Pino | 32 | 7,3 |
| Comprado | 42 | 31,4 |
| Estofado | 11 | 12,2 |
| **Total (sem piloto)** | 249 | 135,5 |

| Perfil | Comprimento total (m) | kg/m | Massa (kg) |
|---|---|---|---|
| Tubo 10 x 20 x 1,2 mm | 2,95 | 0,520 | 1,5 |
| Tubo 20 x 30 x 1,2 mm | 41,25 | 0,897 | 37,0 |
| Tubo 30 x 50 x 1,2 mm | 14,87 | 1,462 | 21,7 |

## Tubos (segmentos)

| Código | Conjunto | Descrição | Dimensões (mm) | Corte | Massa (kg) |
|---|---|---|---|---|---|
| B-T01 | Plataforma-base | Longarina base E | 20x30 x 2070 | reto | 1,84 |
| B-T02 | Plataforma-base | Longarina base D | 20x30 x 2070 | reto | 1,84 |
| B-T03 | Plataforma-base | Travessa base y-190 | 20x30 x 660 | reto | 0,57 |
| B-T04 | Plataforma-base | Travessa base y40 | 20x30 x 640 | reto | 0,57 |
| B-T05 | Plataforma-base | Travessa base y300 | 20x30 x 640 | reto | 0,57 |
| B-T06 | Plataforma-base | Travessa base y560 | 20x30 x 640 | reto | 0,57 |
| B-T07 | Plataforma-base | Travessa base y650 | 20x30 x 640 | reto | 0,57 |
| B-T08 | Plataforma-base | Travessa base y840 | 20x30 x 640 | reto | 0,57 |
| B-T09 | Plataforma-base | Travessa base y1100 | 20x30 x 640 | reto | 0,57 |
| B-T10 | Plataforma-base | Travessa base y1700 | 20x30 x 640 | reto | 0,57 |
| B-T11 | Plataforma-base | Travessa base y1840 | 20x30 x 660 | reto | 0,57 |
| B-T12 | Plataforma-base | Diagonal base | 10x20 x 807 | ângulo (eixo a 46° / 44° / 90° de X / Y / Z) | 0,42 |
| B-T13 | Plataforma-base | Apoio motor E | 20x30 x 210 | reto | 0,19 |
| B-T14 | Plataforma-base | Longarina apoio chapa motor E | 20x30 x 210 | reto | 0,19 |
| B-T15 | Plataforma-base | Apoio motor D | 20x30 x 210 | reto | 0,19 |
| B-T16 | Plataforma-base | Longarina apoio chapa motor D | 20x30 x 210 | reto | 0,19 |
| B-T17 | Plataforma-base | Perna torre pivo | 20x30 x 281 | ângulo (eixo a 54° / 65° / 46° de X / Y / Z) | 0,24 |
| B-T18 | Plataforma-base | Perna torre pivo | 20x30 x 281 | ângulo (eixo a 54° / 65° / 46° de X / Y / Z) | 0,24 |
| B-T19 | Plataforma-base | Perna torre pivo | 20x30 x 281 | ângulo (eixo a 54° / 65° / 46° de X / Y / Z) | 0,24 |
| B-T20 | Plataforma-base | Perna torre pivo | 20x30 x 281 | ângulo (eixo a 54° / 65° / 46° de X / Y / Z) | 0,24 |
| B-T21 | Plataforma-base | Coluna batente E | 20x30 x 110 | reto | 0,10 |
| B-T22 | Plataforma-base | Coluna batente D | 20x30 x 110 | reto | 0,10 |
| M-T01 | Chassi móvel | Longarina principal E | 30x50 x 1785 | reto | 2,59 |
| M-T02 | Chassi móvel | Longarina principal D | 30x50 x 1785 | reto | 2,59 |
| M-T03 | Chassi móvel | Travessa chassi y25 | 30x50 x 540 | reto | 0,75 |
| M-T04 | Chassi móvel | Travessa chassi y300 | 20x30 x 510 | reto | 0,46 |
| M-T05 | Chassi móvel | Travessa chassi y650 | 30x50 x 510 | reto | 0,75 |
| M-T06 | Chassi móvel | Travessa chassi y700 | 30x50 x 510 | reto | 0,75 |
| M-T07 | Chassi móvel | Travessa chassi y750 | 30x50 x 510 | reto | 0,75 |
| M-T08 | Chassi móvel | Travessa chassi y900 | 20x30 x 510 | reto | 0,46 |
| M-T09 | Chassi móvel | Travessa chassi y1100 | 20x30 x 510 | reto | 0,46 |
| M-T10 | Chassi móvel | Travessa chassi y1450 | 20x30 x 510 | reto | 0,46 |
| M-T11 | Chassi móvel | Travessa chassi y1765 | 20x30 x 510 | reto | 0,46 |
| M-T12 | Chassi móvel | Diagonal piso y25-300 | 10x20 x 480 | ângulo (eixo a 31° / 59° / 90° de X / Y / Z) | 0,25 |
| M-T13 | Chassi móvel | Diagonal piso y1100-1450 | 10x20 x 538 | ângulo (eixo a 38° / 52° / 90° de X / Y / Z) | 0,28 |
| M-T14 | Chassi móvel | Banzo inferior soleira E y60-300 | 30x50 x 271 | ângulo (eixo a 90° / 28° / 62° de X / Y / Z) | 0,32 |
| M-T15 | Chassi móvel | Banzo inferior soleira E y300-700 | 30x50 x 420 | ângulo (eixo a 90° / 11° / 79° de X / Y / Z) | 0,59 |
| M-T16 | Chassi móvel | Banzo inferior soleira E y700-1132 | 30x50 x 481 | ângulo (eixo a 90° / 25° / 65° de X / Y / Z) | 0,61 |
| M-T17 | Chassi móvel | Montante soleira E y324 | 20x30 x 88 | reto | 0,08 |
| M-T18 | Chassi móvel | Montante soleira E y670 | 20x30 x 152 | reto | 0,13 |
| M-T19 | Chassi móvel | Diagonal soleira E y324-670 | 20x30 x 318 | ângulo (eixo a 90° / 6° / 84° de X / Y / Z) | 0,29 |
| M-T20 | Chassi móvel | Trilho banco E | 30x50 x 1100 | reto | 1,61 |
| M-T21 | Chassi móvel | Trilho pedaleira E | 30x50 x 1035 | reto | 1,51 |
| M-T22 | Chassi móvel | Trilho banco D | 30x50 x 1100 | reto | 1,61 |
| M-T23 | Chassi móvel | Trilho pedaleira D | 30x50 x 1035 | reto | 1,51 |
| BC-T01 | Banco | Longarina carro banco E | 20x30 x 437 | reto | 0,37 |
| BC-T02 | Banco | Longarina carro banco D | 20x30 x 437 | reto | 0,37 |
| BC-T03 | Banco | Travessa carro banco tras | 20x30 x 300 | reto | 0,25 |
| BC-T04 | Banco | Travessa carro banco diant | 20x30 x 300 | reto | 0,25 |
| BC-T05 | Banco | Biela banco E Tras | 20x30 x 390 | reto | 0,35 |
| BC-T06 | Banco | Biela banco D Tras | 20x30 x 390 | reto | 0,35 |
| BC-T07 | Banco | Biela banco E Diant | 20x30 x 390 | reto | 0,35 |
| BC-T08 | Banco | Biela banco D Diant | 20x30 x 390 | reto | 0,35 |
| BC-T09 | Banco | Longarina subchassi E | 20x30 x 361 | reto | 0,32 |
| BC-T10 | Banco | Montante articulacao E | 20x30 x 111 | ângulo (eixo a 90° / 45° / 45° de X / Y / Z) | 0,09 |
| BC-T11 | Banco | Longarina subchassi D | 20x30 x 361 | reto | 0,32 |
| BC-T12 | Banco | Montante articulacao D | 20x30 x 111 | ângulo (eixo a 90° / 45° / 45° de X / Y / Z) | 0,09 |
| BC-T13 | Banco | Espinha assento | 20x30 x 440 | reto | 0,39 |
| BC-T14 | Banco | Espinha encosto | 20x30 x 440 | reto | 0,39 |
| BC-T15 | Banco | Espinha apoio superior | 20x30 x 440 | reto | 0,39 |
| BC-T16 | Banco | Tirante paralelo apoio superior E | 10x20 x 564 | reto | 0,29 |
| BC-T17 | Banco | Tirante paralelo apoio superior D | 10x20 x 564 | reto | 0,29 |
| BC-T18 | Banco | Haste comando encosto E | 20x30 x 287 | reto | 0,26 |
| BC-T19 | Banco | Haste comando encosto D | 20x30 x 287 | reto | 0,26 |
| BC-T20 | Banco | Haste comando assento | 20x30 x 292 | reto | 0,26 |
| BC-T21 | Banco | Travessa carro banco haste encosto | 20x30 x 280 | reto | 0,25 |
| M-T24 | Chassi móvel | Travessa suporte tirante arrasto | 20x30 x 510 | reto | 0,46 |
| BC-T22 | Banco | Tirante de arrasto do carro E | 20x30 x 68 | reto | 0,06 |
| BC-T23 | Banco | Tirante de arrasto do carro D | 20x30 x 68 | reto | 0,06 |
| PE-T01 | Pedaleira | Longarina carro pedaleira E | 20x30 x 230 | reto | 0,21 |
| PE-T02 | Pedaleira | Torre pivo pedaleira E | 20x30 x 90 | reto | 0,08 |
| PE-T03 | Pedaleira | Longarina carro pedaleira D | 20x30 x 230 | reto | 0,21 |
| PE-T04 | Pedaleira | Torre pivo pedaleira D | 20x30 x 90 | reto | 0,08 |
| PE-T05 | Pedaleira | Travessa carro pedaleira | 20x30 x 440 | reto | 0,39 |
| PE-T06 | Pedaleira | Braco pedaleira inferior E | 20x30 x 370 | ângulo (eixo a 90° / 20° / 70° de X / Y / Z) | 0,25 |
| PE-T07 | Pedaleira | Braco pedaleira superior E | 20x30 x 596 | ângulo (eixo a 90° / 44° / 46° de X / Y / Z) | 0,47 |
| PE-T08 | Pedaleira | Braco pedaleira inferior D | 20x30 x 370 | ângulo (eixo a 90° / 20° / 70° de X / Y / Z) | 0,25 |
| PE-T09 | Pedaleira | Braco pedaleira superior D | 20x30 x 596 | ângulo (eixo a 90° / 44° / 46° de X / Y / Z) | 0,47 |
| PE-T10 | Pedaleira | Travessa pedaleira inferior | 20x30 x 400 | reto | 0,36 |
| PE-T11 | Pedaleira | Travessa pedaleira superior | 20x30 x 360 | reto | 0,32 |
| PE-T12 | Pedaleira | Tubo de torcao pedaleira | 20x30 x 360 | reto | 0,32 |
| PE-T13 | Pedaleira | Alavanca haste pedaleira | 20x30 x 230 | reto | 0,21 |
| PE-T14 | Pedaleira | Haste comando pedaleira | 20x30 x 210 | reto | 0,19 |
| PE-T15 | Pedaleira | Poste suporte haste pedaleira | 20x30 x 320 | reto | 0,29 |
| PE-T16 | Pedaleira | Mao-francesa poste haste pedaleira | 20x30 x 392 | ângulo (eixo a 90° / 48° / 42° de X / Y / Z) | 0,32 |
| M-T25 | Chassi móvel | Travessa suporte haste pedaleira | 20x30 x 510 | reto | 0,46 |
| VO-T01 | Volante | Coluna volante E | 30x50 x 728 | reto | 1,06 |
| VO-T02 | Volante | Coluna volante D | 30x50 x 728 | reto | 1,06 |
| VO-T03 | Volante | Tubo de torcao volante | 30x50 x 504 | reto | 0,74 |
| VO-T04 | Volante | Braco volante E | 30x50 x 463 | ângulo (eixo a 90° / 24° / 66° de X / Y / Z) | 0,67 |
| VO-T05 | Volante | Braco volante D | 30x50 x 463 | ângulo (eixo a 90° / 24° / 66° de X / Y / Z) | 0,67 |
| VO-T06 | Volante | Alavanca came volante E | 20x30 x 152 | reto | 0,14 |
| VO-T07 | Volante | Alavanca came volante D | 20x30 x 152 | reto | 0,14 |
| A-T01 | Anel estrutural | Coluna anel D y25 | 20x30 x 585 | reto | 0,52 |
| A-T02 | Anel estrutural | Coluna anel D y400 | 20x30 x 585 | reto | 0,52 |
| A-T03 | Anel estrutural | Coluna anel D y1000 | 20x30 x 585 | reto | 0,52 |
| A-T04 | Anel estrutural | Coluna anel D y1765 | 20x30 x 585 | reto | 0,52 |
| A-T05 | Anel estrutural | Coluna anel E y25 | 20x30 x 585 | reto | 0,52 |
| A-T06 | Anel estrutural | Coluna anel E y200 | 20x30 x 585 | reto | 0,52 |
| A-T07 | Anel estrutural | Coluna anel E y1132 | 20x30 x 585 | reto | 0,52 |
| A-T08 | Anel estrutural | Coluna anel E y1450 | 20x30 x 585 | reto | 0,52 |
| A-T09 | Anel estrutural | Coluna anel E y1765 | 20x30 x 585 | reto | 0,52 |
| A-T10 | Anel estrutural | Anel lado D | 20x30 x 1770 | reto | 1,59 |
| A-T11 | Anel estrutural | Travessa traseira rebaixada | 20x30 x 570 | reto | 0,51 |
| A-T12 | Anel estrutural | Anel dianteiro | 20x30 x 570 | reto | 0,51 |
| A-T13 | Anel estrutural | Anel lado E traseiro | 20x30 x 205 | reto | 0,18 |
| A-T14 | Anel estrutural | Anel lado E dianteiro | 20x30 x 663 | reto | 0,59 |
| A-T15 | Anel estrutural | Diagonal anel D y25-400 | 20x30 x 592 | ângulo (eixo a 90° / 54° / 36° de X / Y / Z) | 0,53 |
| A-T16 | Anel estrutural | Diagonal anel D y400-1000 | 20x30 x 763 | ângulo (eixo a 90° / 42° / 48° de X / Y / Z) | 0,68 |
| A-T17 | Anel estrutural | Diagonal anel E y25-200 | 20x30 x 427 | ângulo (eixo a 90° / 70° / 20° de X / Y / Z) | 0,38 |
| A-T18 | Anel estrutural | Diagonal anel E y1132-1450 | 20x30 x 549 | ângulo (eixo a 90° / 58° / 32° de X / Y / Z) | 0,49 |
| A-T19 | Anel estrutural | Diagonal quadro traseiro | 20x30 x 638 | ângulo (eixo a 27° / 90° / 63° de X / Y / Z) | 0,57 |
| A-T20 | Anel estrutural | Diagonal quadro dianteiro | 20x30 x 723 | ângulo (eixo a 38° / 90° / 52° de X / Y / Z) | 0,65 |
| A-T21 | Anel estrutural | Mao-francesa suporte cambio | 20x30 x 116 | ângulo (eixo a 2° / 90° / 88° de X / Y / Z) | 0,10 |
| PO-T01 | Barra da porta | Barra da porta | 30x50 x 903 | reto | 1,32 |

## Chapas e peças usinadas

| Código | Conjunto | Descrição | Dimensões (mm) | Corte | Massa (kg) |
|---|---|---|---|---|---|
| B-CH01 | Plataforma-base | Chapa topo torre pivo 160x160x8 | 160 x 160 x 8 |  | 1,61 |
| B-CH02 | Plataforma-base | Chapa suporte motor 6mm E | 177 x 120 x 6 |  | 1,00 |
| B-CH03 | Plataforma-base | Calco motor E | 87 x 60 x 20 |  | 0,82 |
| B-CH04 | Plataforma-base | Braco manivela 10mm E | 150 x 50 x 10 |  | 0,59 |
| B-CH05 | Plataforma-base | Chapa suporte motor 6mm D | 177 x 120 x 6 |  | 1,00 |
| B-CH06 | Plataforma-base | Calco motor D | 87 x 60 x 20 |  | 0,82 |
| B-CH07 | Plataforma-base | Braco manivela 10mm D | 150 x 50 x 10 |  | 0,59 |
| M-CH01 | Chassi móvel | Chapa pivo 300x140x8 | 300 x 140 x 8 |  | 2,64 |
| M-CH02 | Chassi móvel | Suporte haste traseira E | 50 x 45 x 20 |  | 0,35 |
| M-CH03 | Chassi móvel | Suporte haste traseira D | 50 x 45 x 20 |  | 0,35 |
| BC-CH01 | Banco | Mancal biela tras E | 40 x 27 x 20 |  | 0,17 |
| BC-CH02 | Banco | Mancal biela diant E | 75 x 40 x 20 |  | 0,47 |
| BC-CH03 | Banco | Mancal biela tras D | 40 x 27 x 20 |  | 0,17 |
| BC-CH04 | Banco | Mancal biela diant D | 75 x 40 x 20 |  | 0,47 |
| BC-CH05 | Banco | Orelha tirante subchassi E | 52 x 27 x 8 |  | 0,09 |
| BC-CH06 | Banco | Orelha tirante apoio E | 40 x 30 x 8 |  | 0,08 |
| BC-CH07 | Banco | Orelha tirante subchassi D | 52 x 27 x 8 |  | 0,09 |
| BC-CH08 | Banco | Orelha tirante apoio D | 40 x 30 x 8 |  | 0,08 |
| BC-CH09 | Banco | Alavanca encosto E (chapa 12x70) | 175 x 70 x 12 |  | 1,15 |
| BC-CH10 | Banco | Suporte haste encosto E | 40 x 30 x 12 |  | 0,11 |
| BC-CH11 | Banco | Alavanca encosto D (chapa 12x70) | 175 x 70 x 12 |  | 1,15 |
| BC-CH12 | Banco | Suporte haste encosto D | 40 x 30 x 12 |  | 0,11 |
| BC-CH13 | Banco | Orelha haste assento (chapa 12) | 95 x 70 x 12 |  | 0,63 |
| BC-CH14 | Banco | Suporte haste assento | 40 x 37 x 12 |  | 0,14 |
| BC-CH15 | Banco | Suporte tirante arrasto E | 128 x 24 x 20 |  | 0,48 |
| BC-CH16 | Banco | Suporte tirante arrasto D | 128 x 24 x 20 |  | 0,48 |
| PE-CH01 | Pedaleira | Chapa fixacao pedais 400x331x2 | 400 x 331 x 2 |  | 2,08 |
| VO-CH01 | Volante | Patim trilho mastro E | 80 x 30 x 12 |  | 0,23 |
| VO-CH02 | Volante | Guia superior coluna/anel E | 80 x 50 x 6 |  | 0,19 |
| VO-CH03 | Volante | Guia inferior coluna/anel E | 80 x 50 x 6 |  | 0,19 |
| VO-CH04 | Volante | Patim trilho mastro D | 80 x 30 x 12 |  | 0,23 |
| VO-CH05 | Volante | Guia superior coluna/anel D | 80 x 50 x 6 |  | 0,19 |
| VO-CH06 | Volante | Guia inferior coluna/anel D | 80 x 50 x 6 |  | 0,19 |
| VO-CH07 | Volante | Mesa volante 300x240x3 | 300 x 240 x 3 |  | 1,70 |
| VO-CH08 | Volante | Chapa came volante 4mm E | 235 x 140 x 4 |  | 1,04 |
| VO-CH09 | Volante | Chapa came volante 4mm D | 235 x 140 x 4 |  | 1,04 |
| A-CH01 | Anel estrutural | Chapa suporte cambio 190x140x6 | 190 x 150 x 6 |  | 1,34 |
| PO-CH01 | Barra da porta | Orelhas dobradica porta | 44 x 40 x 30 |  | 0,41 |
| PO-CH02 | Barra da porta | Fecho da porta - orelha externa | 40 x 35 x 6 |  | 0,07 |
| PO-CH03 | Barra da porta | Fecho da porta - orelha interna | 40 x 35 x 6 |  | 0,07 |
| PO-CH04 | Barra da porta | Fecho da porta - apoio | 35 x 32 x 6 |  | 0,05 |
| MO-CH01 | Molas de centragem | Olhal base mola arfagem tras | 30 x 30 x 8 |  | 0,06 |
| MO-CH02 | Molas de centragem | Olhal chassi mola arfagem tras | 30 x 30 x 8 |  | 0,06 |
| MO-CH03 | Molas de centragem | Olhal base mola arfagem diant | 30 x 30 x 8 |  | 0,06 |
| MO-CH04 | Molas de centragem | Olhal chassi mola arfagem diant | 30 x 30 x 8 |  | 0,06 |
| MO-CH05 | Molas de centragem | Olhal base mola rolagem E | 30 x 30 x 8 |  | 0,06 |
| MO-CH06 | Molas de centragem | Olhal chassi mola rolagem E | 30 x 30 x 8 |  | 0,06 |
| MO-CH07 | Molas de centragem | Olhal base mola rolagem D | 30 x 30 x 8 |  | 0,06 |
| MO-CH08 | Molas de centragem | Olhal chassi mola rolagem D | 30 x 30 x 8 |  | 0,06 |

## Pinos e eixos

| Código | Conjunto | Descrição | Dimensões (mm) | Corte | Massa (kg) |
|---|---|---|---|---|---|
| B-PI01 | Plataforma-base | Eixo saida redutor E | Ø20 x 23 |  | 0,06 |
| B-PI02 | Plataforma-base | Eixo saida redutor D | Ø20 x 23 |  | 0,06 |
| BC-PI01 | Banco | Pino mancal biela tras E | Ø16 x 30 |  | 0,05 |
| BC-PI02 | Banco | Pino mancal biela diant E | Ø16 x 30 |  | 0,05 |
| BC-PI03 | Banco | Pino indexador trilho banco E | Ø12 x 60 |  | 0,05 |
| BC-PI04 | Banco | Pino mancal biela tras D | Ø16 x 30 |  | 0,05 |
| BC-PI05 | Banco | Pino mancal biela diant D | Ø16 x 30 |  | 0,05 |
| BC-PI06 | Banco | Pino indexador trilho banco D | Ø12 x 60 |  | 0,05 |
| BC-PI07 | Banco | Pino biela subchassi E | Ø16 x 90 |  | 0,14 |
| BC-PI08 | Banco | Pino biela subchassi E | Ø16 x 90 |  | 0,14 |
| BC-PI09 | Banco | Pino biela subchassi D | Ø16 x 90 |  | 0,14 |
| BC-PI10 | Banco | Pino biela subchassi D | Ø16 x 90 |  | 0,14 |
| BC-PI11 | Banco | Eixo articulacao assento/encosto | Ø20 x 580 |  | 1,43 |
| BC-PI12 | Banco | Eixo articulacao apoio superior | Ø18 x 524 |  | 1,05 |
| BC-PI13 | Banco | Pino tirante inferior E | Ø12 x 24 |  | 0,02 |
| BC-PI14 | Banco | Pino tirante superior E | Ø12 x 24 |  | 0,02 |
| BC-PI15 | Banco | Pino tirante inferior D | Ø12 x 24 |  | 0,02 |
| BC-PI16 | Banco | Pino tirante superior D | Ø12 x 24 |  | 0,02 |
| BC-PI17 | Banco | Pino tirante arrasto na biela E | Ø12 x 24 |  | 0,02 |
| BC-PI18 | Banco | Pino tirante arrasto na biela D | Ø12 x 24 |  | 0,02 |
| PE-PI01 | Pedaleira | Pino indexador trilho pedaleira E | Ø12 x 60 |  | 0,05 |
| PE-PI02 | Pedaleira | Pino indexador trilho pedaleira D | Ø12 x 60 |  | 0,05 |
| PE-PI03 | Pedaleira | Eixo pivo pedaleira | Ø18 x 490 |  | 0,98 |
| PE-PI04 | Pedaleira | Pino haste/alavanca pedaleira | Ø16 x 50 |  | 0,08 |
| PE-PI05 | Pedaleira | Pino haste pedaleira no poste | Ø16 x 48 |  | 0,08 |
| VO-PI01 | Volante | Pino indexador mastro E | Ø12 x 24 |  | 0,02 |
| VO-PI02 | Volante | Pino indexador mastro D | Ø12 x 24 |  | 0,02 |
| VO-PI03 | Volante | Eixo pivo volante | Ø25 x 600 |  | 2,31 |
| VO-PI04 | Volante | Pino seguidor came volante E | Ø12 x 24 |  | 0,02 |
| VO-PI05 | Volante | Pino seguidor came volante D | Ø12 x 24 |  | 0,02 |
| PO-PI01 | Barra da porta | Eixo dobradica porta | Ø16 x 50 |  | 0,08 |
| PO-PI02 | Barra da porta | Trava rapida da porta | Ø10 x 48 |  | 0,05 |

## Estofados

| Código | Conjunto | Descrição | Dimensões (mm) | Corte | Massa (kg) |
|---|---|---|---|---|---|
| BC-ES01 | Banco | Assento estofado 480x440x60 | 480 x 440 x 60 |  | 3,00 |
| BC-ES02 | Banco | Aba assento E | 350 x 55 x 50 |  | 0,40 |
| BC-ES03 | Banco | Aba assento D | 350 x 55 x 50 |  | 0,40 |
| BC-ES04 | Banco | Encosto lombar 480x563x60 | 563 x 480 x 60 |  | 3,50 |
| BC-ES05 | Banco | Aba encosto E | 463 x 65 x 50 |  | 0,50 |
| BC-ES06 | Banco | Aba encosto D | 463 x 65 x 50 |  | 0,50 |
| BC-ES07 | Banco | Apoio ombros/cabeca 480x430x60 | 480 x 430 x 60 |  | 2,50 |
| BC-ES08 | Banco | Aba ombro E | 160 x 90 x 30 |  | 0,40 |
| BC-ES09 | Banco | Aba cabeca E | 180 x 100 x 30 |  | 0,30 |
| BC-ES10 | Banco | Aba ombro D | 160 x 90 x 30 |  | 0,40 |
| BC-ES11 | Banco | Aba cabeca D | 180 x 100 x 30 |  | 0,30 |

## Itens comprados (agrupados)

| Especificação | Qtd. | Códigos no desenho |
|---|---|---|
| Junta cardan (cruzeta com rolamentos de agulha), capacidade estatica >= 20 kN | 1 | B-CO01, B-CO02, B-CO03, B-CO04, M-CO05, M-CO06, M-CO07, M-CO08 |
| Redutor planetario 20:1 para NEMA 34 (flange 86 mm), torque nominal de saida >= 150 N.m | 2 | B-CO05, B-CO08 |
| Motor de passo NEMA 34 12 N.m em malha fechada (ex.: 86HSE12N) + driver | 2 | B-CO06, B-CO09 |
| Terminal rotular M16 (rod end) | 4 | B-CO07, B-CO10, M-CO02, M-CO04 |
| Batente de borracha Ø48 x 35 | 2 | B-CO11, B-CO12 |
| Barra rosqueada M16 + porcas (entre rotulas) | 2 | M-CO01, M-CO03 |
| Calco de borracha Ø28 com parafuso (apoio do subchassi em F1) | 4 | BC-CO01, BC-CO02, BC-CO03, BC-CO04 |
| Logitech G920 - pedais (428,5 x 311 x 167 mm, 3,1 kg) | 1 (já possui) | PE-CO01, PE-CO02, PE-CO03, PE-CO04, PE-CO05 |
| Mancal flangeado para eixo Ø25 | 2 | VO-CO01, VO-CO02 |
| Logitech G920 - volante (270 x 260 x 278 mm, 2,25 kg) | 1 (já possui) | VO-CO03, VO-CO04, VO-CO05, VO-CO06 |
| Logitech Driving Force Shifter (130 x 165 x 167 mm, estimado) | 1 (já possui) | A-CO01, A-CO02, A-CO03 |
| Mola de tracao com olhais (rigidez/pre-carga em CALCULOS.md) | 4 | MO-CO01, MO-CO02, MO-CO03, MO-CO04 |
| Pino de trava rapida (ball lock) Ø12 x 60 mm com argola | 4 | BC-PI03, BC-PI06, PE-PI01, PE-PI02 |
| Pino de trava rapida (ball lock) Ø12 x 24 mm com argola | 2 | VO-PI01, VO-PI02 |
| Pino de trava rapida (ball lock) Ø10 x 50 | 1 | PO-PI02 |

## Itens não desenhados (necessários)

| Item | Qtd. | Observação |
|---|---|---|
| Driver para motor de passo em malha fechada (ex.: HBS86H) | 2 | compatível com o motor escolhido em CALCULOS.md |
| Fonte 70–80 VCC, ≥ 600 W | 1 | dimensionar pelo driver |
| Controladora USB (Arduino + firmware de simulador, ou placa dedicada) | 1 | interface com SimTools / FlyPT Mover / SimHub |
| Botão de emergência (corta o enable dos drivers) | 1 | segurança, ver CALCULOS.md §4 |
| Sensores de fim de curso / homing das manivelas | 2 | indutivos ou micro-switch |
| Buchas de aço para articulações (parede ≥ 3 mm) | 2 por pino | ver CALCULOS.md §6.1 |
| Anéis elásticos / travas para pinos | 2 por pino |  |
| Parafusos, porcas e arruelas M6–M16 (kit) | 1 | fixação de chapas, G920, câmbio e estofados |
| Compensado naval 15 mm para bases dos estofados | ≈ 0,6 m² | assento, encosto e apoio |
| Arame/eletrodo de solda, discos de corte e lixa | - | consumíveis |
| Fundo anticorrosivo + tinta | ≈ 1,5 L | área ≈ 6,7 m² de tubo |
| Pés niveladores com borracha | 6 | sob a base |
