marneierencio/cockpit-2dof/solidworks/Cockpit_2DOF_F1.step

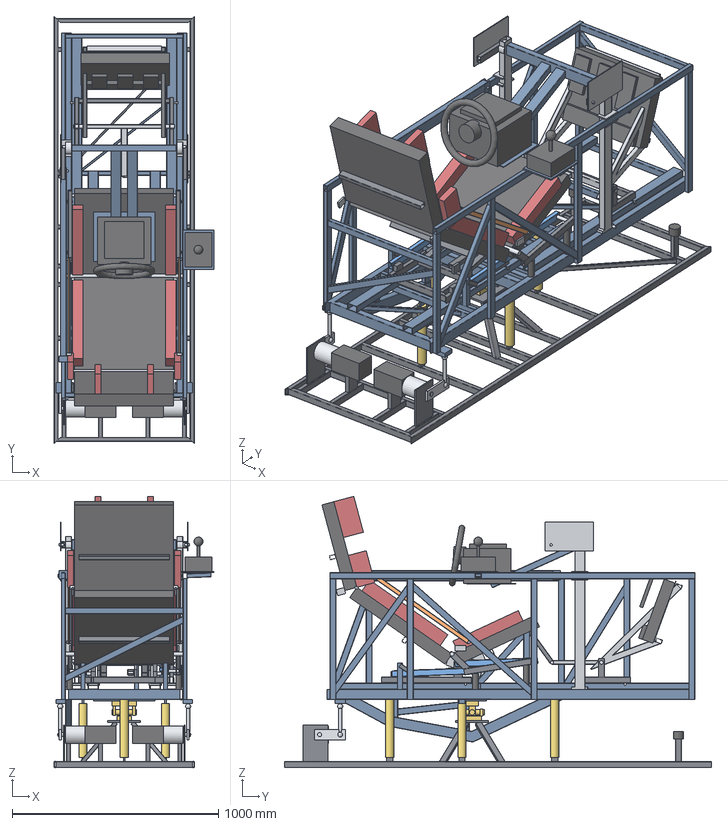
[picture p8: CAD file, 2026-10-23]
solidworks/Cockpit_2DOF_F1.step
775.0 x 2070.0 x 1315.3 mm
M-CO02 Terminal-rotular-inferior-E x 4
SOLD-MOV Soldado-Plataforma-Movel
VO-CH08 Chapa-came-volante-4mm-E-chapa-sem-tubo-de-apoio
VO-CH09 Chapa-came-volante-4mm-D-chapa-sem-tubo-de-apoio
M-CO01 Haste-ligacao-E x 2
BC-CO01 Calco-borracha-apoio-F1-tras-E x 2
BC-CO02 Calco-borracha-apoio-F1-diant-E x 2
PE-PI05 Pino-haste-pedaleira-no-poste
M-CO05 Junta-Cardan-MOV
A-CO01 G920-Cambio-MOV
PO-PI01 Pino-haste-alavanca-pedaleira x 2
SOLD-PORTA Soldado-Porta-Barra
PO-PI02 Trava-rapida-da-porta
SOLD-MASTRO Soldado-Mastro-Volante
SOLD-MASTRO-2 Soldado-Mastro-Volante-2
VO-PI01 Pino-indexador-mastro-E x 2
VO-CO01 Mancal-tubo-torcao-E x 2
VO-PI04 Pino-tirante-arrasto-na-biela-E x 8
SOLD-BRACO Soldado-Braco-Volante
SOLD-BRACO-2 Soldado-Braco-Volante-2
SOLD-BRACO-3 Soldado-Braco-Volante-3
VO-PI03 Eixo-pivo-volante
VO-CO03 G920-Volante-BRACO
SOLD-HASTE_PED Soldado-Haste-Pedaleira
PE-PI01 Pino-indexador-trilho-banco-E x 4
SOLD-PCARRO Soldado-Carro-Pedaleira
PE-PI03 Eixo-pivo-pedaleira
SOLD-DECK Soldado-Pedaleira-Basculante
PE-CO01 G920-Pedais-DECK
SOLD-ARRASTO_D Soldado-Tirante-Carro-D
SOLD-ARRASTO_E Soldado-Tirante-Carro-E
SOLD-CARRO Soldado-Carro-Banco
BC-PI01 Pino-mancal-biela-tras-E x 4
SOLD-HASTE_ASS Soldado-Haste-Assento
SOLD-HASTE_ENC_D Soldado-Haste-Encosto-D
SOLD-HASTE_ENC_E Soldado-Haste-Encosto-E
SOLD-BIELA_D_Diant Soldado-Biela-Banco-D-Diant
SOLD-BIELA_E_Diant Soldado-Biela-Banco-E-Diant
SOLD-BIELA_D_Tras Soldado-Biela-Banco-D-Tras
SOLD-BIELA_E_Tras Soldado-Biela-Banco-E-Tras
SOLD-BANCO Soldado-Banco
SOLD-BANCO-2 Soldado-Banco-2
BC-CH05 Orelha-tirante-subchassi-E-chapa-sem-tubo-de-apo
BC-CH07 Orelha-tirante-subchassi-D-chapa-sem-tubo-de-apo
BC-PI07 Pino-biela-subchassi-E x 4
BC-PI11 Eixo-articulacao-assento-encosto
SOLD-TIRANTE_D Soldado-Tirante-Apoio-D
SOLD-TIRANTE_E Soldado-Tirante-Apoio-E
SOLD-ENCOSTO Soldado-Encosto
BC-CH09 Alavanca-encosto-E-chapa-12x70-chapa-sem-tubo-de
BC-CH11 Alavanca-encosto-D-chapa-12x70-chapa-sem-tubo-de
BC-ES04 Encosto-lombar-480x563x60
BC-ES05 Aba-encosto-E x 2
BC-PI12 Eixo-articulacao-apoio-superior
SOLD-APOIO Soldado-Encosto-Superior
BC-CH06 Orelha-tirante-apoio-E-chapa-sem-tubo-de-apoio
BC-CH08 Orelha-tirante-apoio-D-chapa-sem-tubo-de-apoio
BC-ES07 Apoio-ombros-cabeca-480x430x60
BC-ES08 Aba-ombro-E x 2
BC-ES09 Aba-cabeca-E x 2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
