marneierencio/cockpit-2dof/solidworks/pecas/M-CO05_Junta-Cardan-MOV.step

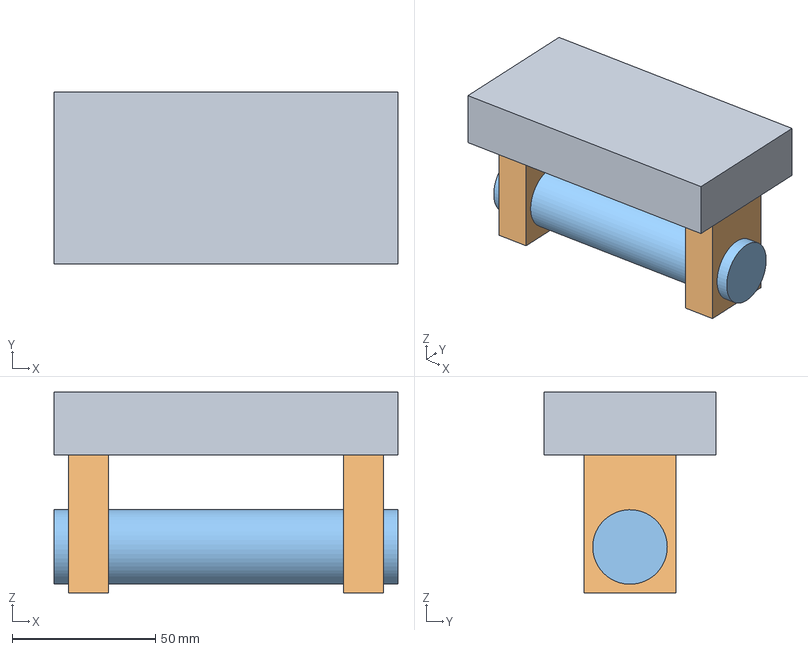
[picture p9: CAD file, 2026-10-23]
solidworks/pecas/M-CO05_Junta-Cardan-MOV.step
120.0 x 60.0 x 70.0 mm
