marneierencio/cockpit-2dof/solidworks/pecas/B-CO07_Terminal-rotular-inferior-E.step

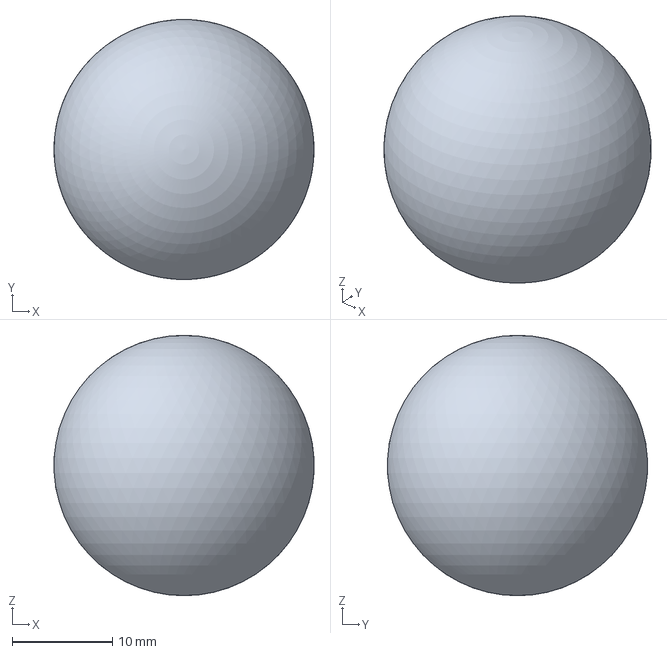
[picture p10: CAD file, 2026-10-23]
solidworks/pecas/B-CO07_Terminal-rotular-inferior-E.step
26.0 x 26.0 x 26.0 mm
