marneierencio/cockpit-2dof/solidworks/pecas/VO-PI01_Pino-indexador-mastro-E.step

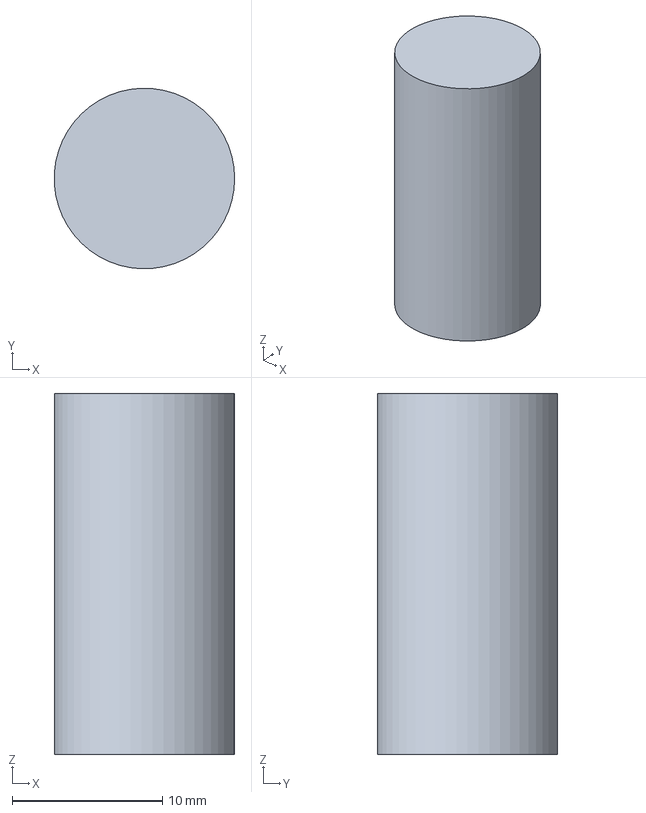
[picture p11: CAD file, 2026-10-23]
solidworks/pecas/VO-PI01_Pino-indexador-mastro-E.step
12.0 x 12.0 x 24.0 mm
