marneierencio/cockpit-2dof/solidworks/pecas/PE-CO01_G920-Pedais-DECK.step

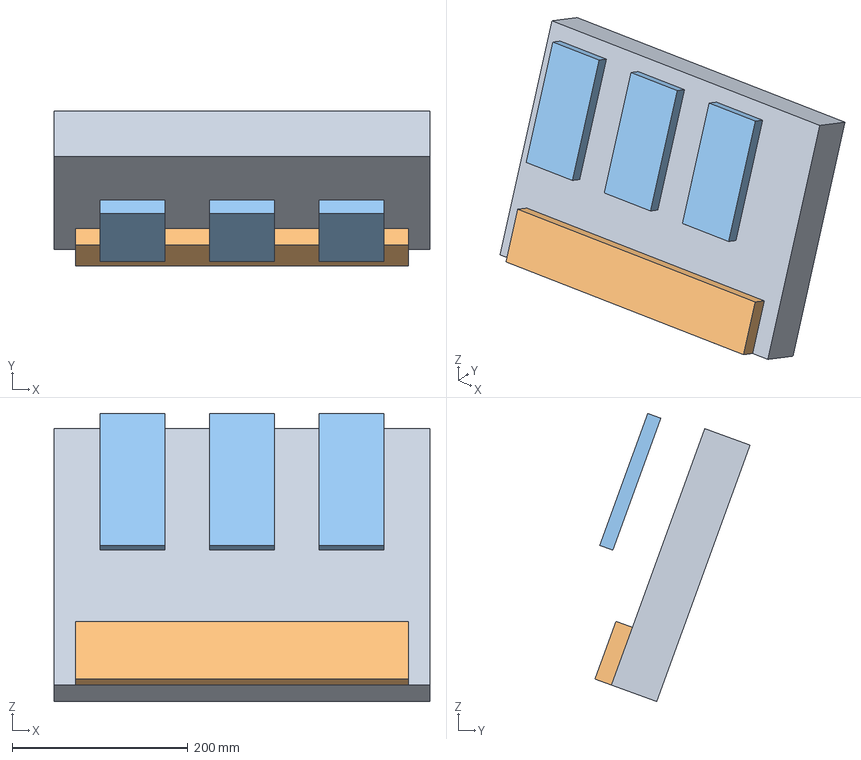
[picture p12: CAD file, 2026-10-23]
solidworks/pecas/PE-CO01_G920-Pedais-DECK.step
428.5 x 176.8 x 328.3 mm
