marneierencio/cockpit-2dof/solidworks/pecas/B-CO06_Motor-de-passo-NEMA-34-E.step

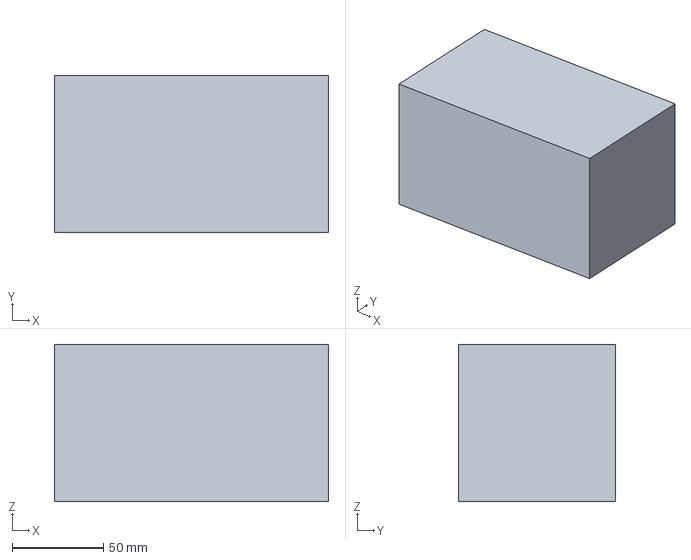
[picture p13: CAD file, 2026-10-23]
solidworks/pecas/B-CO06_Motor-de-passo-NEMA-34-E.step
150.0 x 86.0 x 86.0 mm
