marneierencio/cockpit-2dof/solidworks/pecas/BC-CO01_Calco-borracha-apoio-F1-tras-E.step

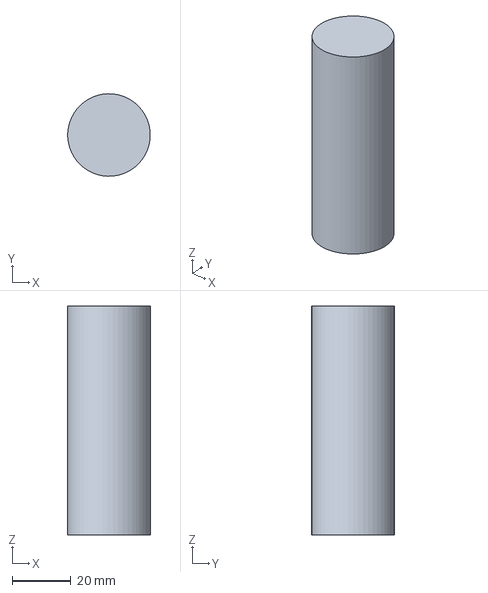
[picture p14: CAD file, 2026-10-23]
solidworks/pecas/BC-CO01_Calco-borracha-apoio-F1-tras-E.step
28.0 x 28.0 x 77.6 mm
