marneierencio/cockpit-2dof/solidworks/pecas/MO-CO01_Mola-de-tracao-arfagem-tras.step

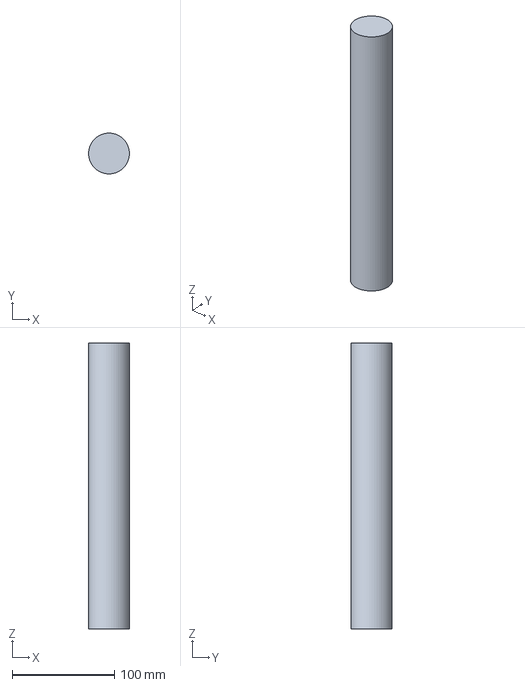
[picture p15: CAD file, 2026-10-23]
solidworks/pecas/MO-CO01_Mola-de-tracao-arfagem-tras.step
40.0 x 40.0 x 280.0 mm
