marneierencio/cockpit-2dof/solidworks/pecas/BC-CH07_Orelha-tirante-subchassi-D-chapa-sem-tubo-de-apo.step

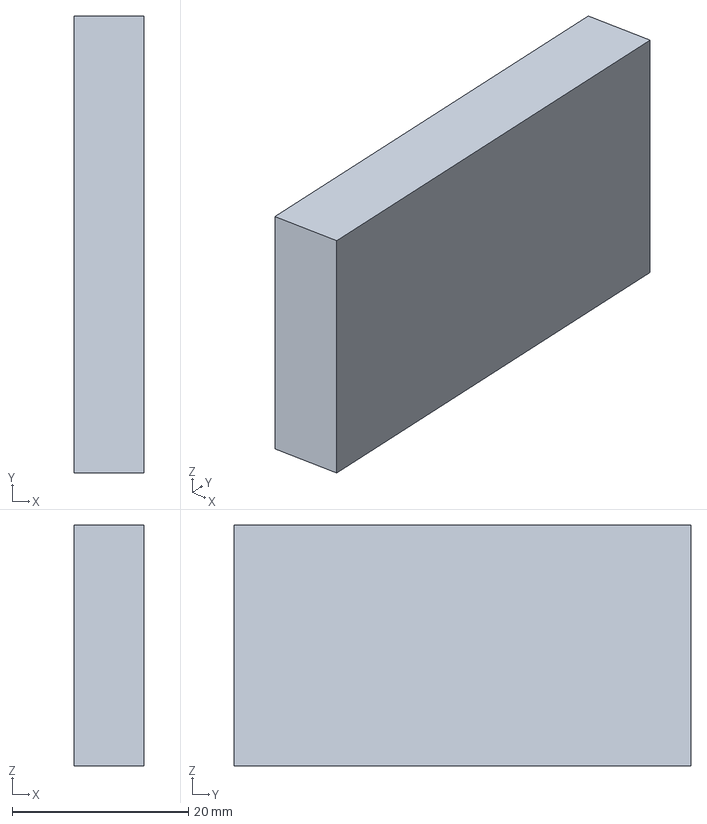
[picture p16: CAD file, 2026-10-23]
solidworks/pecas/BC-CH07_Orelha-tirante-subchassi-D-chapa-sem-tubo-de-apo.step
8.00 x 51.9 x 27.4 mm
