marneierencio/cockpit-2dof/solidworks/pecas/VO-CH08_Chapa-came-volante-4mm-E-chapa-sem-tubo-de-apoio.step

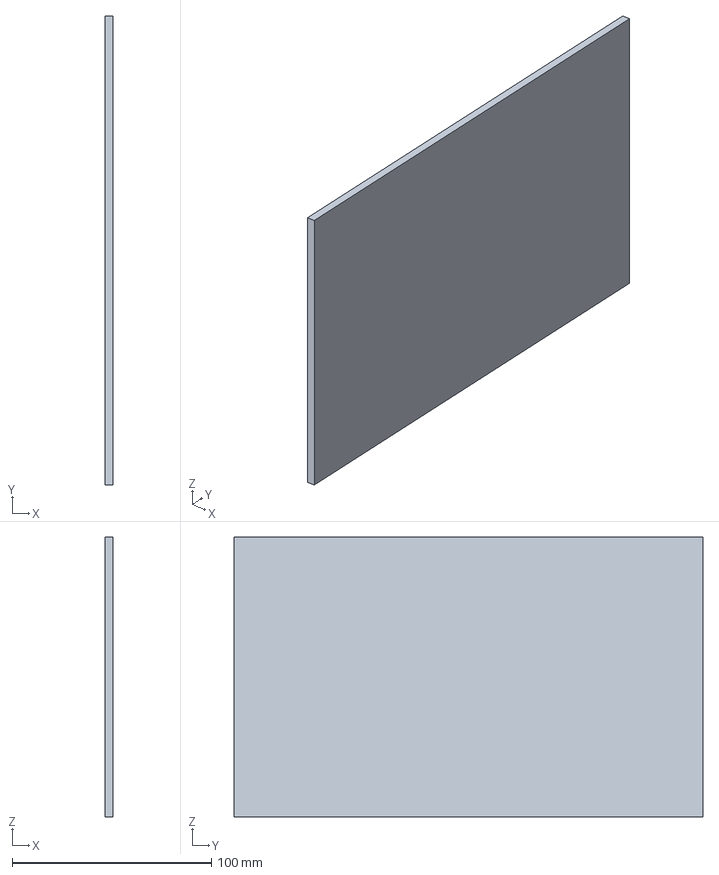
[picture p17: CAD file, 2026-10-23]
solidworks/pecas/VO-CH08_Chapa-came-volante-4mm-E-chapa-sem-tubo-de-apoio.step
4.00 x 235.3 x 140.3 mm
