marneierencio/cockpit-2dof/solidworks/pecas/B-PI01_Eixo-saida-redutor-E.step

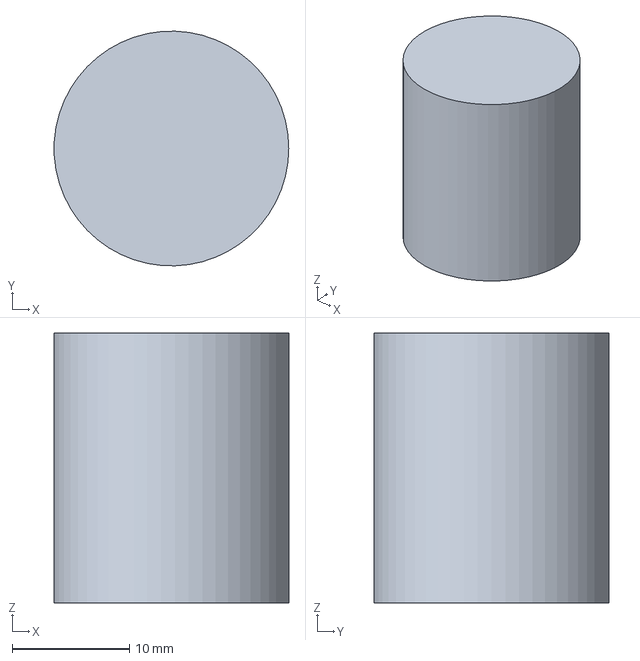
[picture p18: CAD file, 2026-10-23]
solidworks/pecas/B-PI01_Eixo-saida-redutor-E.step
20.0 x 20.0 x 23.0 mm
