marneierencio/cockpit-2dof/solidworks/pecas/PE-PI05_Pino-haste-pedaleira-no-poste.step

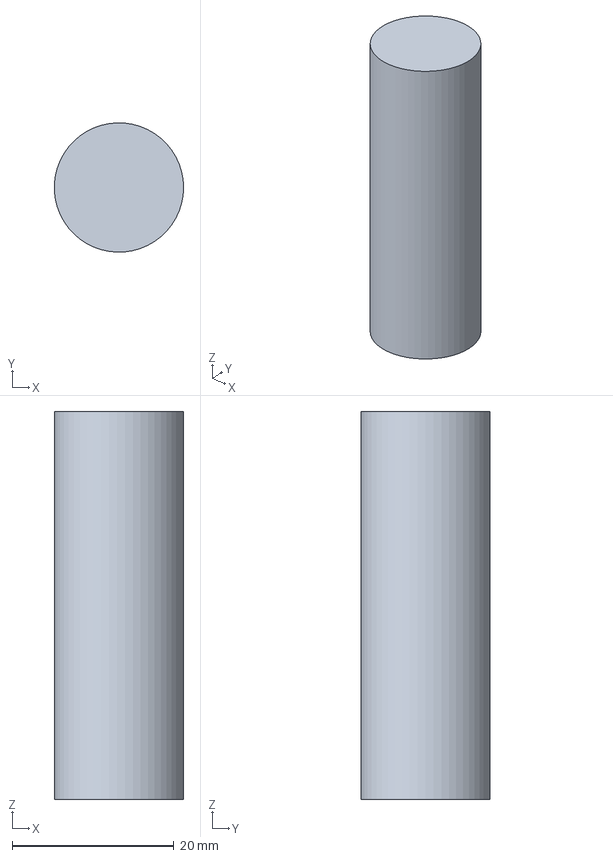
[picture p19: CAD file, 2026-10-23]
solidworks/pecas/PE-PI05_Pino-haste-pedaleira-no-poste.step
16.0 x 16.0 x 48.0 mm
