marneierencio/cockpit-2dof/solidworks/pecas/BC-CH13_Orelha-haste-assento-chapa-12-chapa-sem-tubo-de-.step

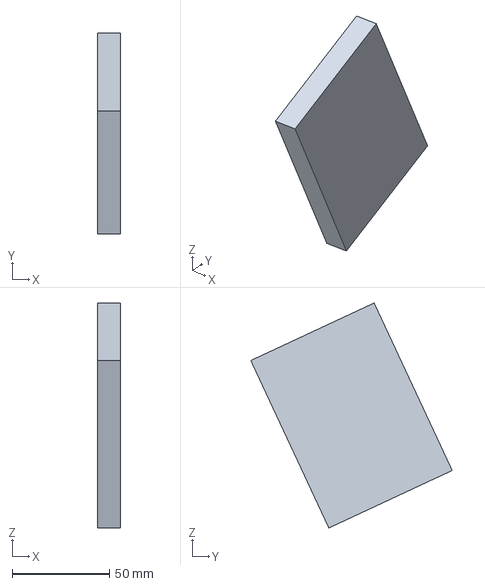
[picture p20: CAD file, 2026-10-23]
solidworks/pecas/BC-CH13_Orelha-haste-assento-chapa-12-chapa-sem-tubo-de-.step
12.0 x 103.6 x 115.7 mm
