marneierencio/cockpit-2dof/solidworks/pecas/BC-PI12_Eixo-articulacao-apoio-superior.step

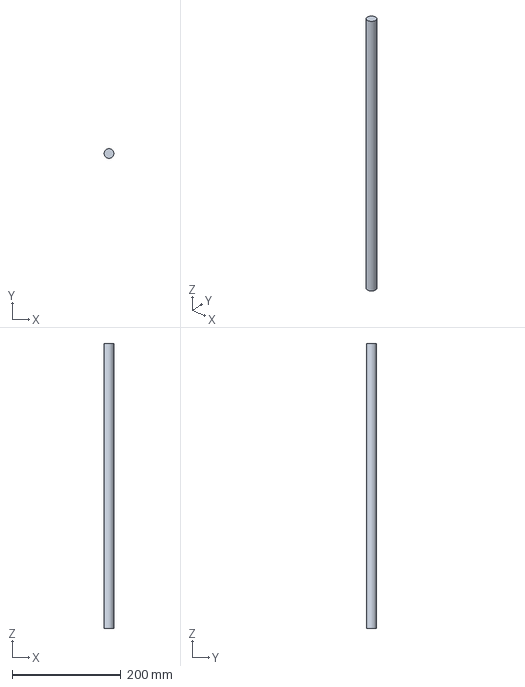
[picture p21: CAD file, 2026-10-23]
solidworks/pecas/BC-PI12_Eixo-articulacao-apoio-superior.step
18.0 x 18.0 x 524.0 mm
