marneierencio/cockpit-2dof/solidworks/pecas/VO-PI03_Eixo-pivo-volante.step

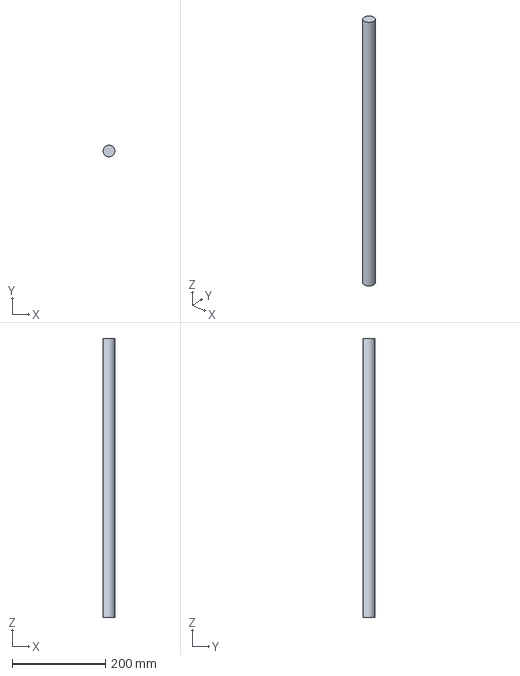
[picture p22: CAD file, 2026-10-23]
solidworks/pecas/VO-PI03_Eixo-pivo-volante.step
25.0 x 25.0 x 600.0 mm
