marneierencio/cockpit-2dof/solidworks/pecas/SOLD-BIELA_D_Tras_Soldado-Biela-Banco-D-Tras.step

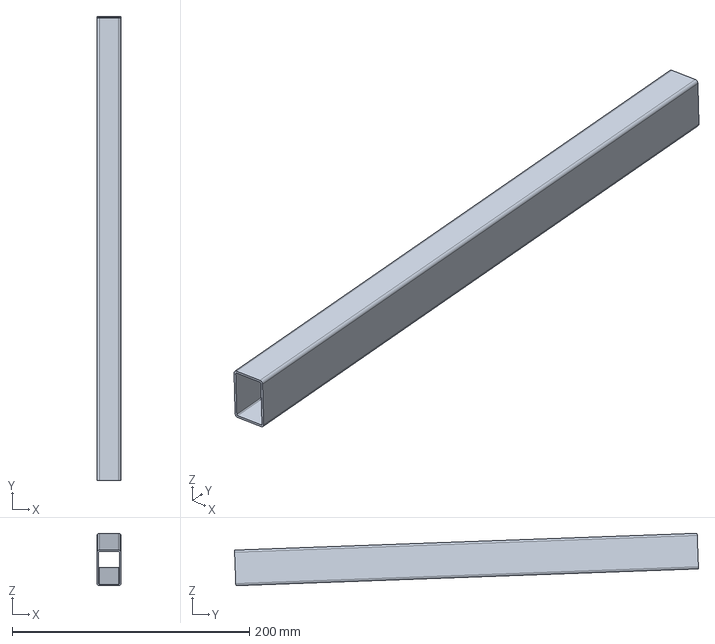
[picture p23: CAD file, 2026-10-23]
solidworks/pecas/SOLD-BIELA_D_Tras_Soldado-Biela-Banco-D-Tras.step
20.0 x 390.8 x 44.2 mm
