marneierencio/cockpit-2dof/solidworks/pecas/SOLD-BANCO_Soldado-Banco.step

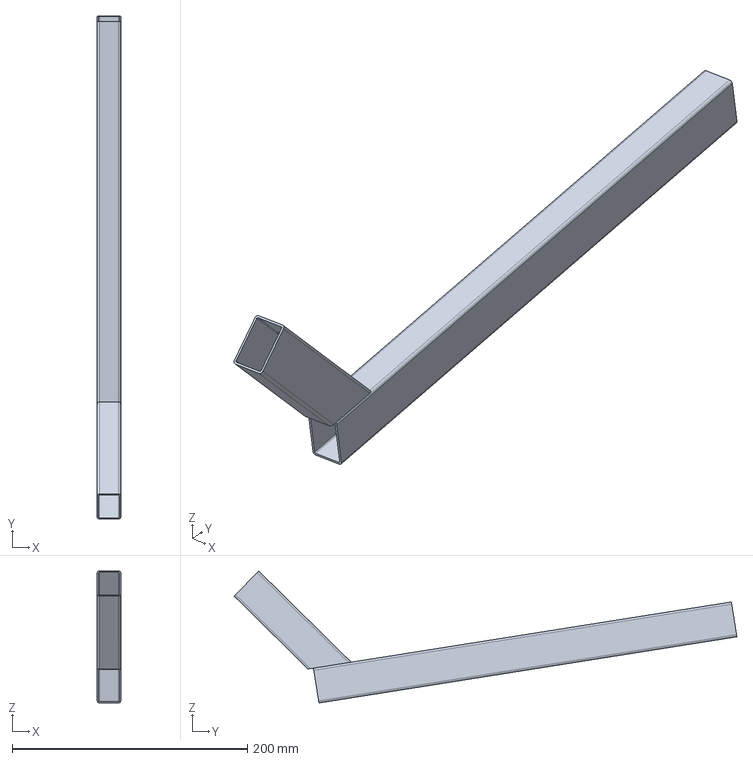
[picture p24: CAD file, 2026-10-23]
solidworks/pecas/SOLD-BANCO_Soldado-Banco.step
20.0 x 427.8 x 112.3 mm
