marneierencio/cockpit-2dof/solidworks/pecas/SOLD-ASSENTO_Soldado-Assento.step

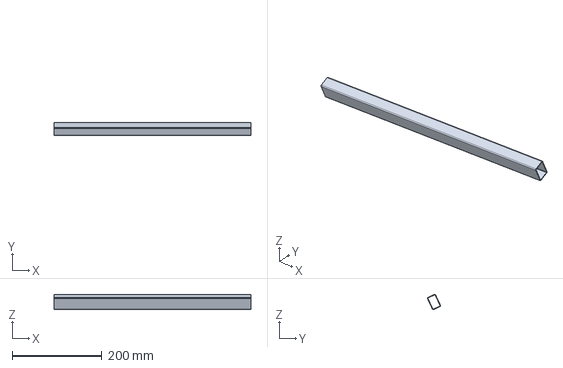
[picture p25: CAD file, 2026-10-23]
solidworks/pecas/SOLD-ASSENTO_Soldado-Assento.step
440.0 x 29.6 x 34.5 mm
