marneierencio/cockpit-2dof/solidworks/pecas/SOLD-MASTRO_Soldado-Mastro-Volante.step

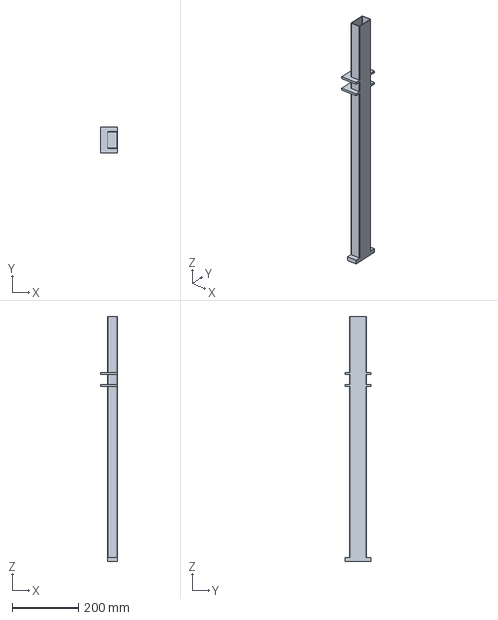
[picture p26: CAD file, 2026-10-23]
solidworks/pecas/SOLD-MASTRO_Soldado-Mastro-Volante.step
50.0 x 80.0 x 740.0 mm
