marneierencio/cockpit-2dof/solidworks/pecas/BC-ES01_Assento-estofado-480x440x60.step

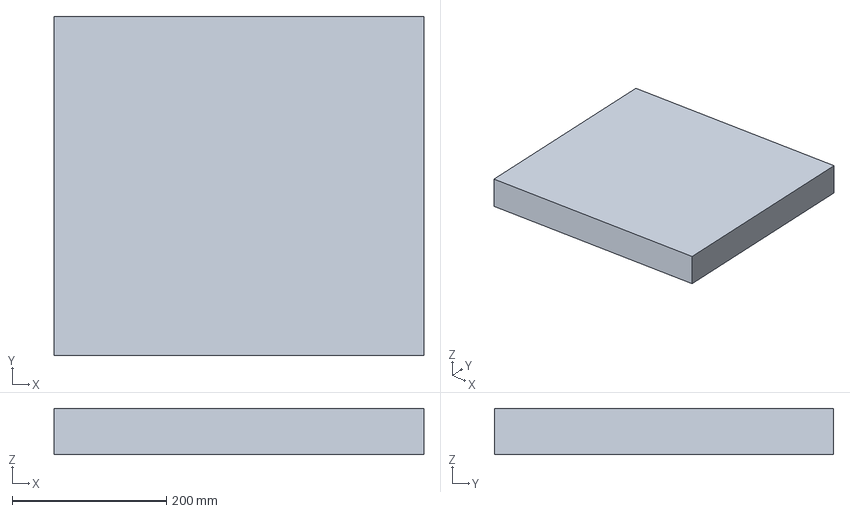
[picture p27: CAD file, 2026-10-23]
solidworks/pecas/BC-ES01_Assento-estofado-480x440x60.step
480.0 x 440.0 x 60.0 mm
