marneierencio/cockpit-2dof/solidworks/pecas/BC-PI01_Pino-mancal-biela-tras-E.step

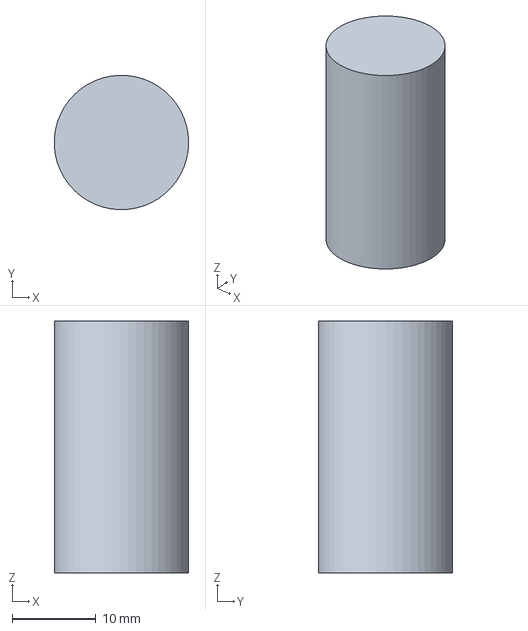
[picture p28: CAD file, 2026-10-23]
solidworks/pecas/BC-PI01_Pino-mancal-biela-tras-E.step
16.0 x 16.0 x 30.0 mm
