marneierencio/cockpit-2dof/solidworks/pecas/PE-PI04_Pino-haste-alavanca-pedaleira.step

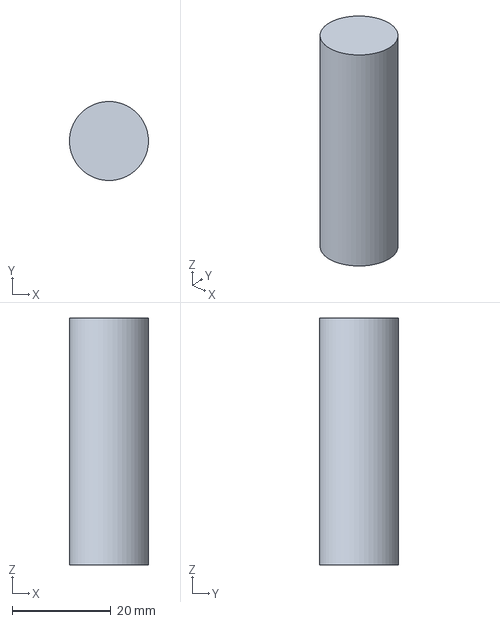
[picture p29: CAD file, 2026-10-23]
solidworks/pecas/PE-PI04_Pino-haste-alavanca-pedaleira.step
16.0 x 16.0 x 50.0 mm
