marneierencio/cockpit-2dof/solidworks/pecas/B-CO05_Redutor-planetario-E.step

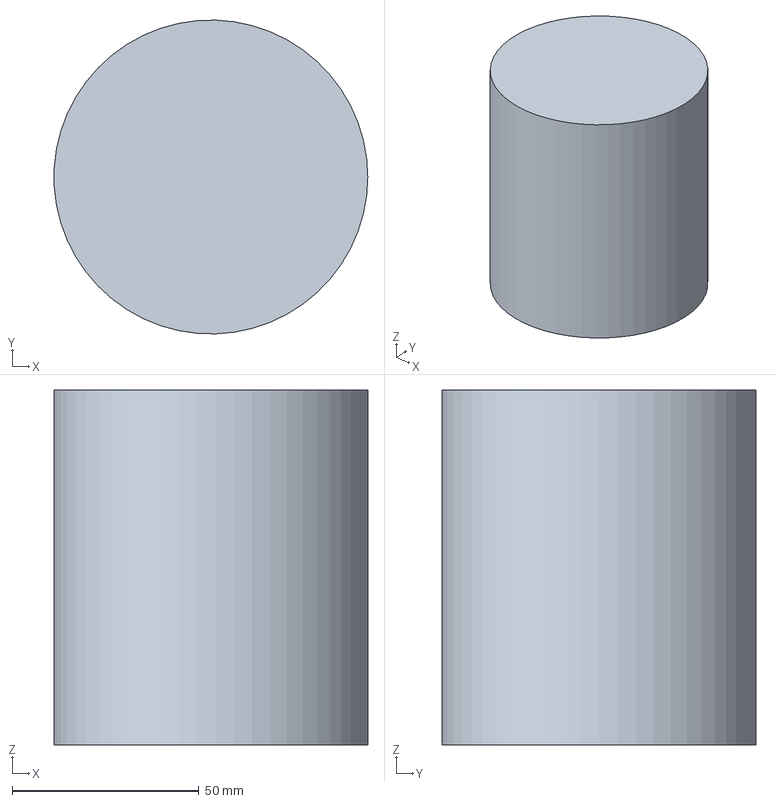
[picture p30: CAD file, 2026-10-23]
solidworks/pecas/B-CO05_Redutor-planetario-E.step
83.9 x 84.0 x 95.0 mm
