marneierencio/cockpit-2dof/solidworks/pecas/SOLD-PCARRO_Soldado-Carro-Pedaleira.step

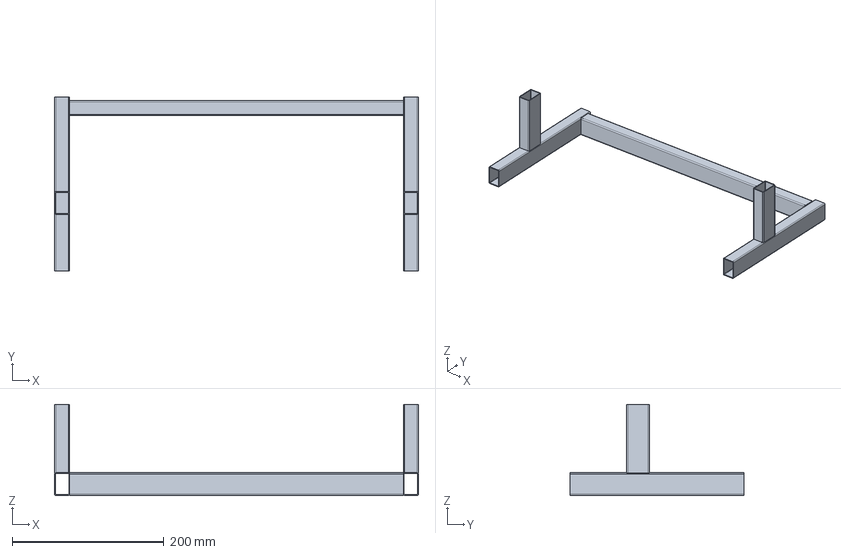
[picture p31: CAD file, 2026-10-23]
solidworks/pecas/SOLD-PCARRO_Soldado-Carro-Pedaleira.step
480.0 x 230.0 x 120.0 mm
