marneierencio/cockpit-2dof/solidworks/pecas/BC-ES08_Aba-ombro-E.step

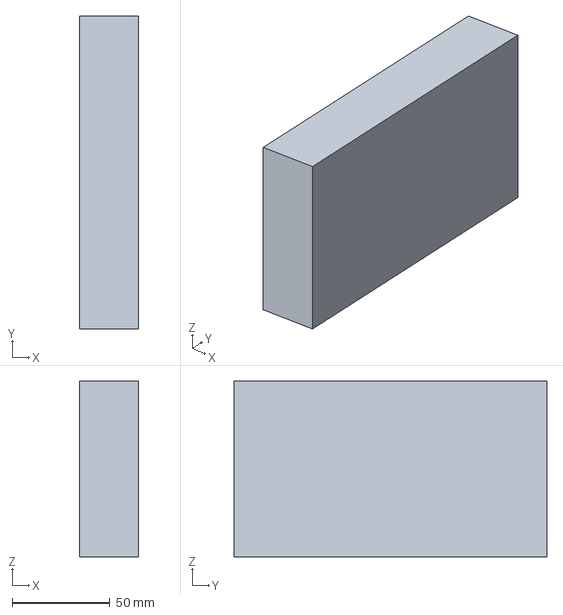
[picture p32: CAD file, 2026-10-23]
solidworks/pecas/BC-ES08_Aba-ombro-E.step
30.0 x 160.0 x 90.0 mm
