marneierencio/cockpit-2dof/solidworks/pecas/SOLD-TIRANTE_D_Soldado-Tirante-Apoio-D.step

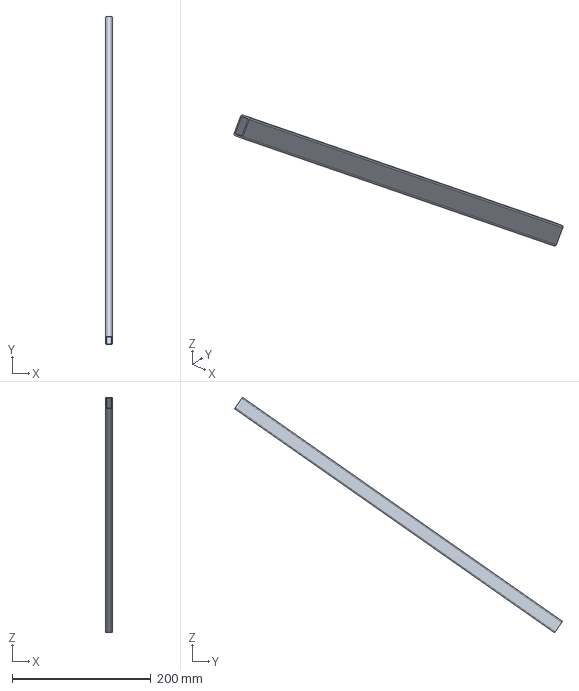
[picture p33: CAD file, 2026-10-23]
solidworks/pecas/SOLD-TIRANTE_D_Soldado-Tirante-Apoio-D.step
10.0 x 472.9 x 339.5 mm
