marneierencio/cockpit-2dof/solidworks/pecas/M-CO01_Haste-ligacao-E.step

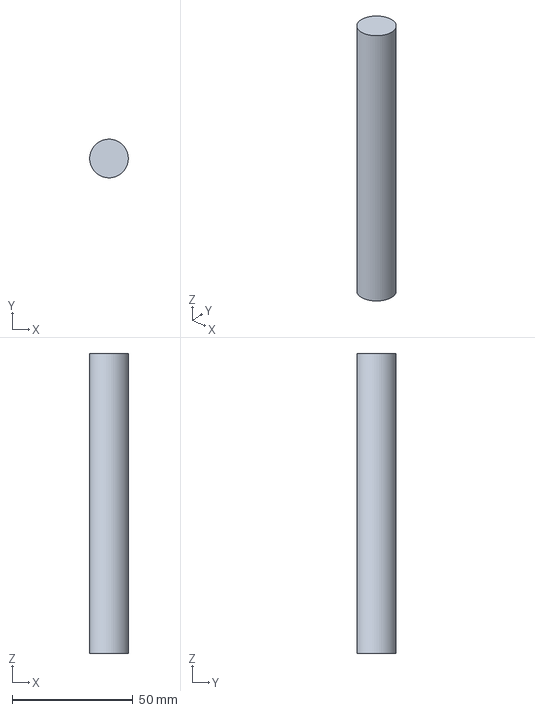
[picture p34: CAD file, 2026-10-23]
solidworks/pecas/M-CO01_Haste-ligacao-E.step
16.0 x 16.0 x 124.0 mm
