marneierencio/cockpit-2dof/solidworks/pecas/BC-ES04_Encosto-lombar-480x563x60.step

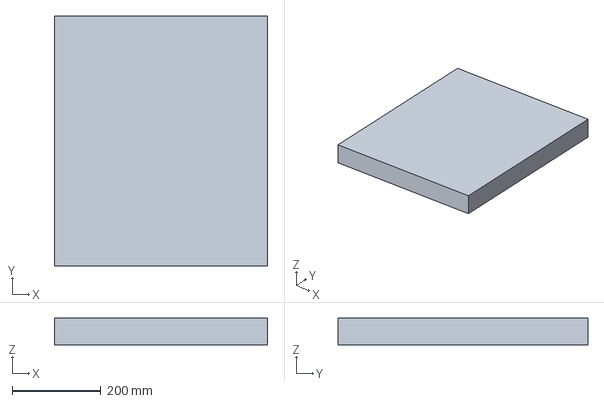
[picture p35: CAD file, 2026-10-23]
solidworks/pecas/BC-ES04_Encosto-lombar-480x563x60.step
480.0 x 563.3 x 60.0 mm
