marneierencio/cockpit-2dof/solidworks/pecas/BC-PI07_Pino-biela-subchassi-E.step

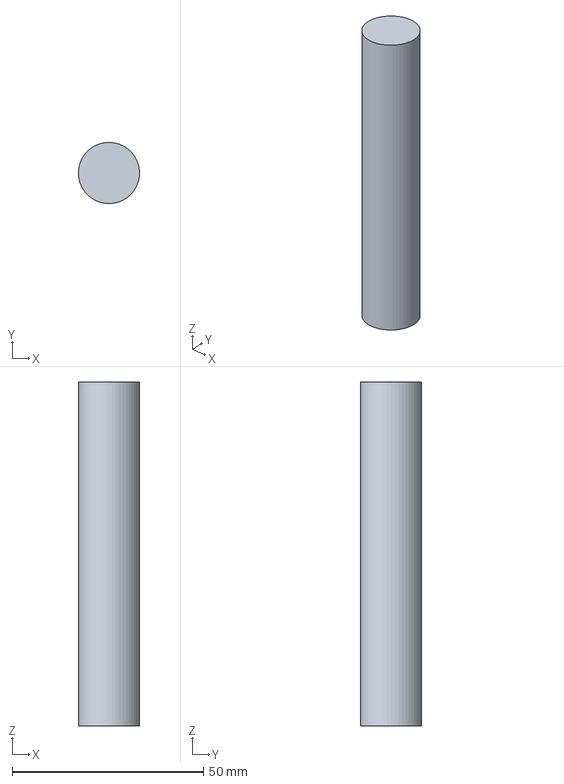
[picture p36: CAD file, 2026-10-23]
solidworks/pecas/BC-PI07_Pino-biela-subchassi-E.step
16.0 x 16.0 x 90.0 mm
