marneierencio/cockpit-2dof/solidworks/pecas/SOLD-BASE_Soldado-Plataforma-Base.step

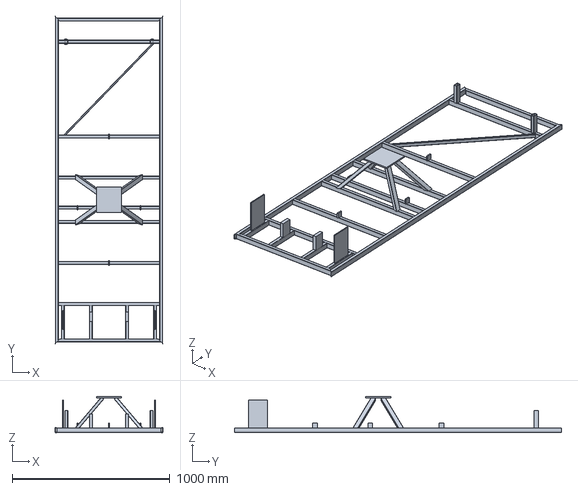
[picture p37: CAD file, 2026-10-23]
solidworks/pecas/SOLD-BASE_Soldado-Plataforma-Base.step
680.0 x 2070.0 x 228.0 mm
