marneierencio/cockpit-2dof/solidworks/pecas/MO-CO03_Mola-de-tracao-rolagem-E.step

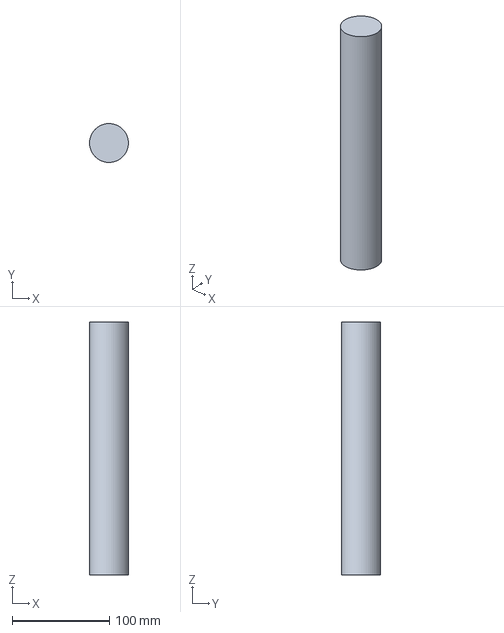
[picture p38: CAD file, 2026-10-23]
solidworks/pecas/MO-CO03_Mola-de-tracao-rolagem-E.step
40.0 x 40.0 x 260.0 mm
