marneierencio/cockpit-2dof/solidworks/pecas/SOLD-HASTE_ENC_E_Soldado-Haste-Encosto-E.step

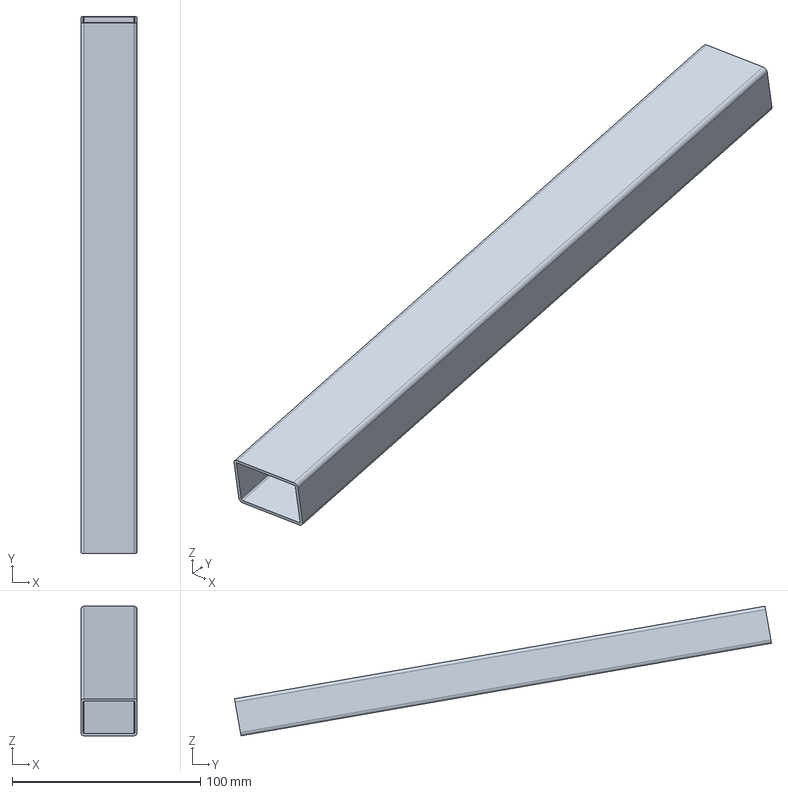
[picture p39: CAD file, 2026-10-23]
solidworks/pecas/SOLD-HASTE_ENC_E_Soldado-Haste-Encosto-E.step
30.0 x 285.5 x 68.9 mm
