marneierencio/cockpit-2dof/solidworks/pecas/BC-CH11_Alavanca-encosto-D-chapa-12x70-chapa-sem-tubo-de.step

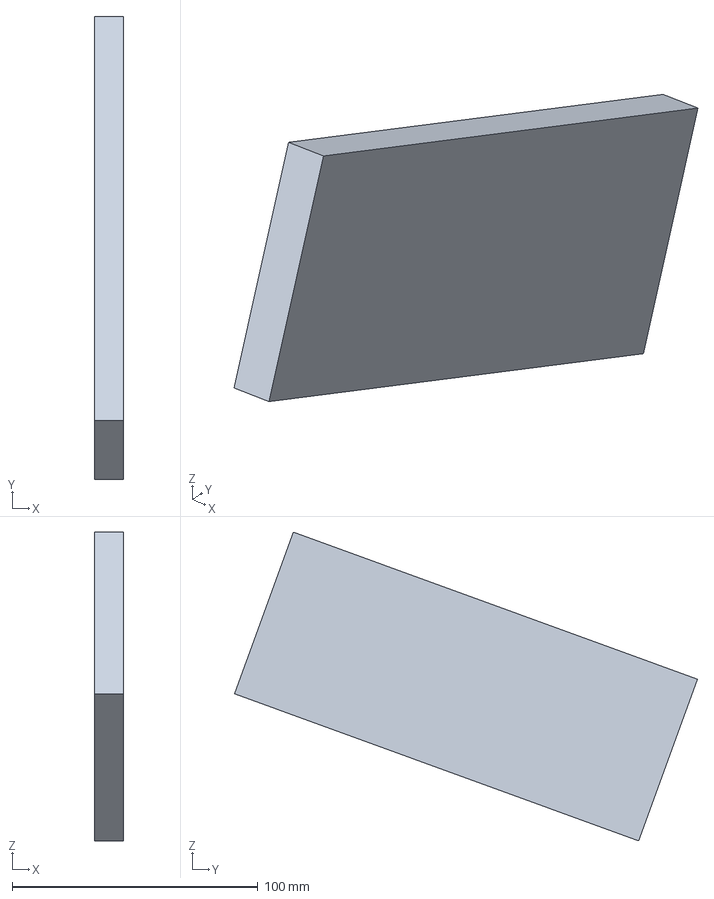
[picture p40: CAD file, 2026-10-23]
solidworks/pecas/BC-CH11_Alavanca-encosto-D-chapa-12x70-chapa-sem-tubo-de.step
12.0 x 188.4 x 125.6 mm
