marneierencio/cockpit-2dof/solidworks/pecas/BC-ES02_Aba-assento-E.step

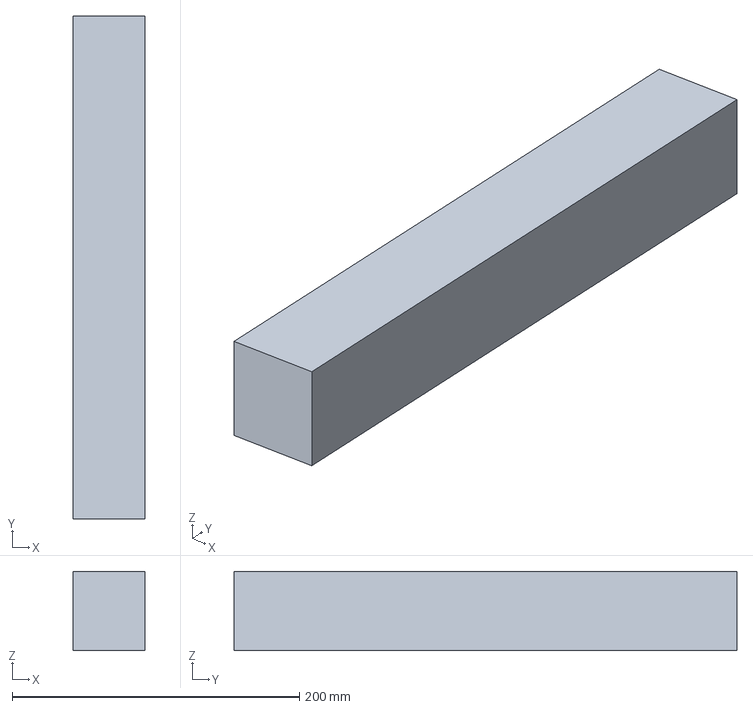
[picture p41: CAD file, 2026-10-23]
solidworks/pecas/BC-ES02_Aba-assento-E.step
50.0 x 350.0 x 55.0 mm
