marneierencio/cockpit-2dof/solidworks/pecas/BC-PI11_Eixo-articulacao-assento-encosto.step

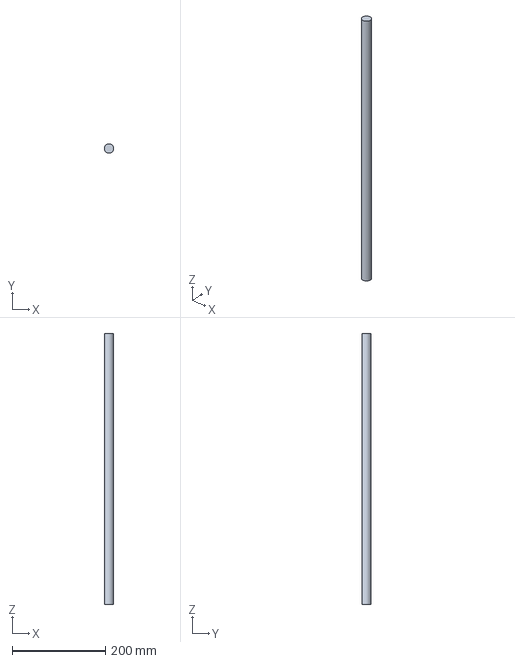
[picture p42: CAD file, 2026-10-23]
solidworks/pecas/BC-PI11_Eixo-articulacao-assento-encosto.step
20.0 x 20.0 x 580.0 mm
