marneierencio/cockpit-2dof/solidworks/pecas/BC-PI03_Pino-indexador-trilho-banco-E.step

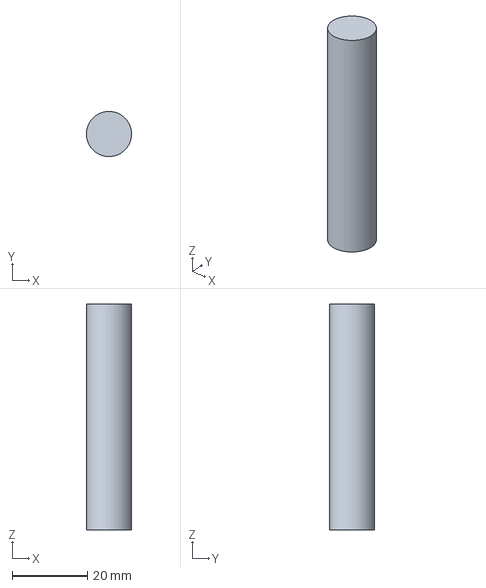
[picture p43: CAD file, 2026-10-23]
solidworks/pecas/BC-PI03_Pino-indexador-trilho-banco-E.step
12.0 x 12.0 x 60.0 mm
