marneierencio/cockpit-2dof/solidworks/pecas/BC-ES07_Apoio-ombros-cabeca-480x430x60.step

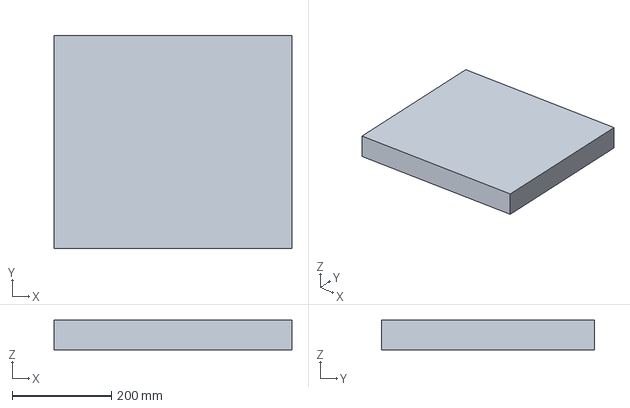
[picture p44: CAD file, 2026-10-23]
solidworks/pecas/BC-ES07_Apoio-ombros-cabeca-480x430x60.step
480.0 x 430.0 x 60.0 mm
