marneierencio/cockpit-2dof/solidworks/pecas/B-CO11_Batente-borracha-E.step

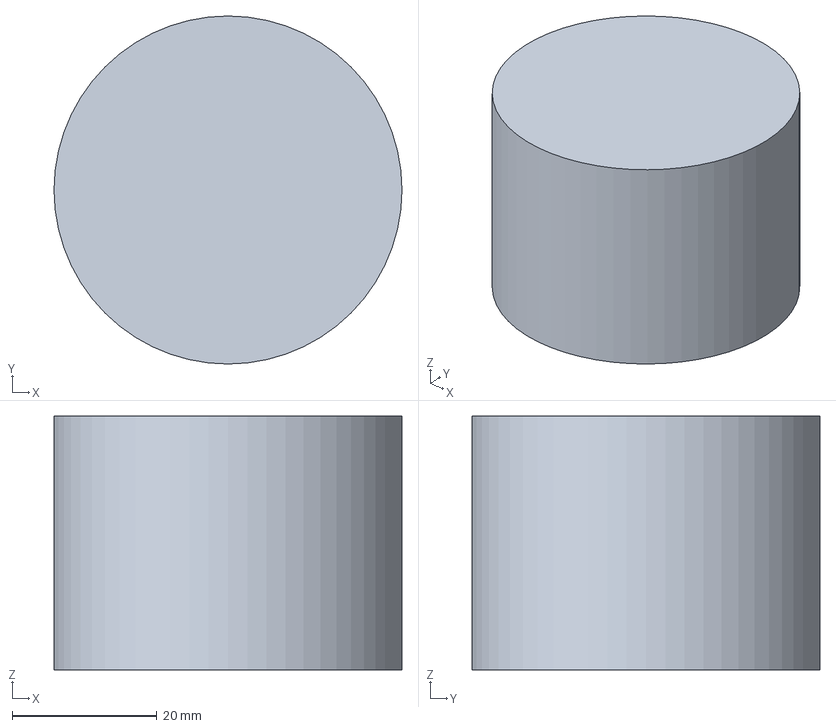
[picture p45: CAD file, 2026-10-23]
solidworks/pecas/B-CO11_Batente-borracha-E.step
48.0 x 48.0 x 35.0 mm
