marneierencio/cockpit-2dof/solidworks/pecas/PE-PI03_Eixo-pivo-pedaleira.step

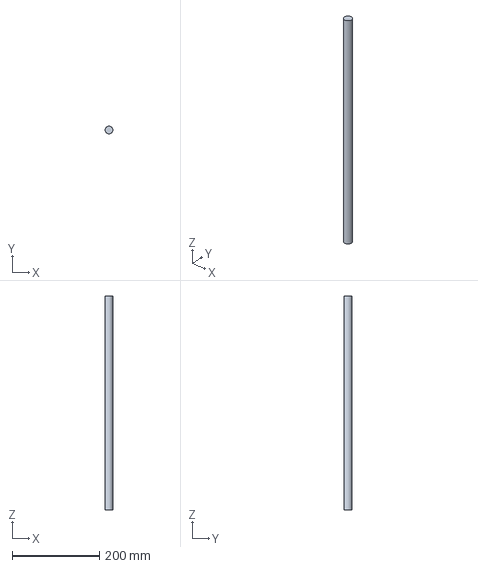
[picture p46: CAD file, 2026-10-23]
solidworks/pecas/PE-PI03_Eixo-pivo-pedaleira.step
18.0 x 18.0 x 490.0 mm
