marneierencio/cockpit-2dof/solidworks/pecas/BC-CH06_Orelha-tirante-apoio-E-chapa-sem-tubo-de-apoio.step

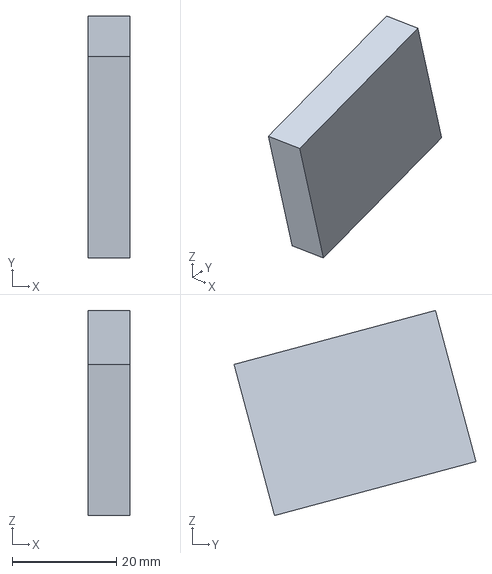
[picture p47: CAD file, 2026-10-23]
solidworks/pecas/BC-CH06_Orelha-tirante-apoio-E-chapa-sem-tubo-de-apoio.step
8.00 x 46.4 x 39.3 mm
