marneierencio/cockpit-2dof/solidworks/pecas/SOLD-BRACO-2_Soldado-Braco-Volante-2.step

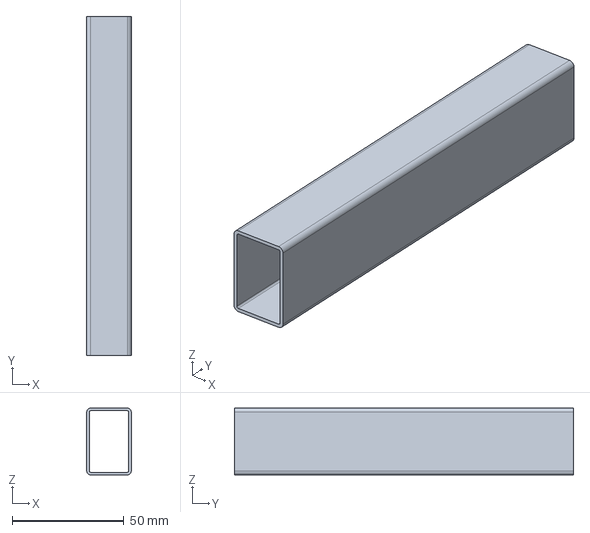
[picture p48: CAD file, 2026-10-23]
solidworks/pecas/SOLD-BRACO-2_Soldado-Braco-Volante-2.step
20.0 x 152.0 x 30.0 mm
