marneierencio/cockpit-2dof/solidworks/pecas/SOLD-ENCOSTO_Soldado-Encosto.step

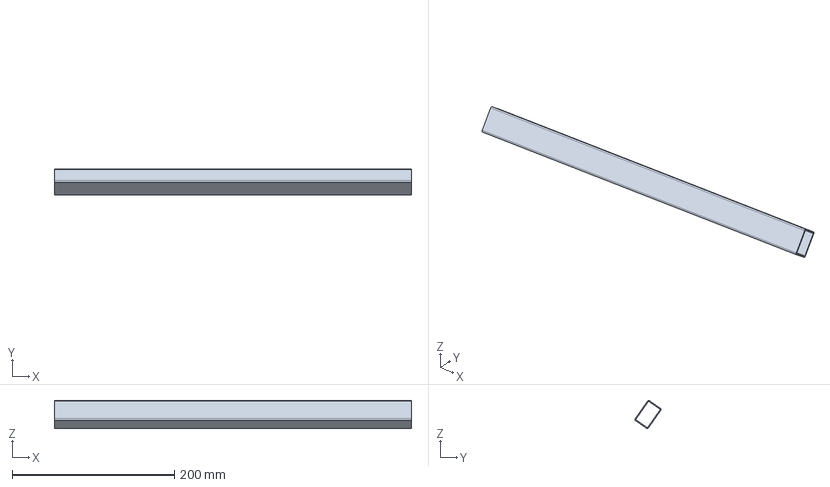
[picture p49: CAD file, 2026-10-23]
solidworks/pecas/SOLD-ENCOSTO_Soldado-Encosto.step
440.0 x 32.2 x 34.6 mm
