marneierencio/cockpit-2dof/solidworks/pecas/SOLD-MOV_Soldado-Plataforma-Movel.step

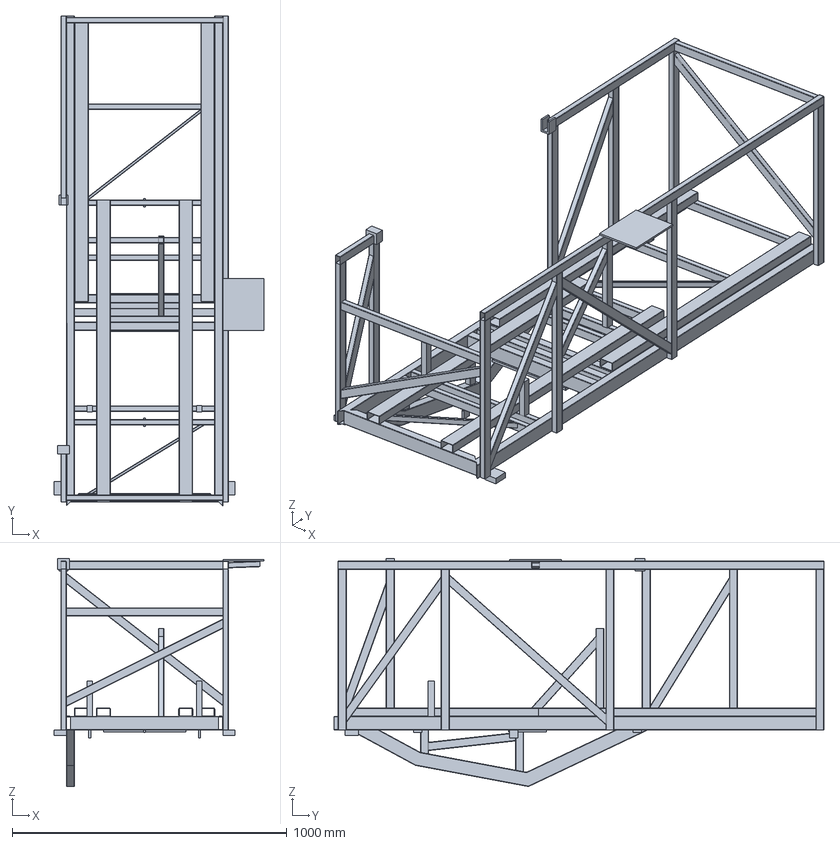
[picture p50: CAD file, 2026-10-23]
solidworks/pecas/SOLD-MOV_Soldado-Plataforma-Movel.step
765.0 x 1785.0 x 831.1 mm
