marneierencio/cockpit-2dof/solidworks/pecas/SOLD-BRACO_Soldado-Braco-Volante.step

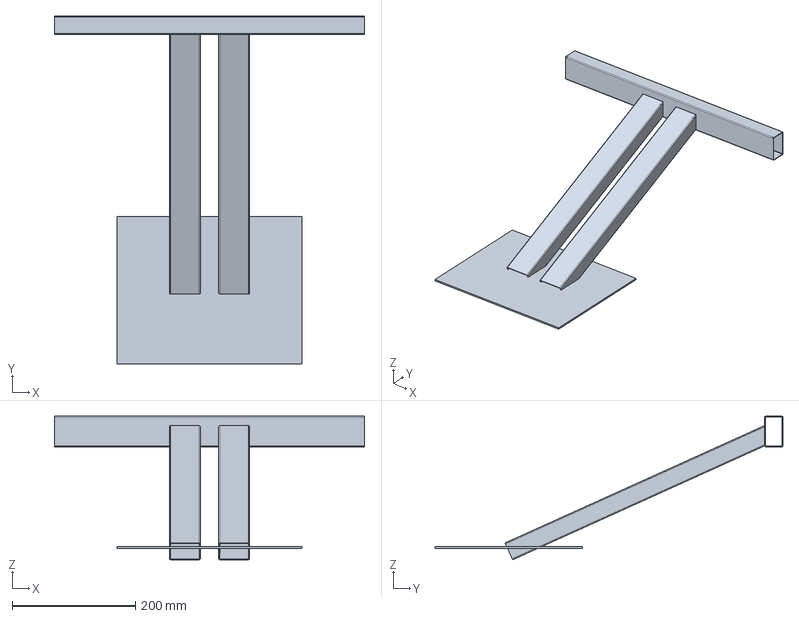
[picture p51: CAD file, 2026-10-23]
solidworks/pecas/SOLD-BRACO_Soldado-Braco-Volante.step
504.0 x 565.7 x 233.4 mm
