marneierencio/cockpit-2dof/solidworks/pecas/VO-CO01_Mancal-tubo-torcao-E.step

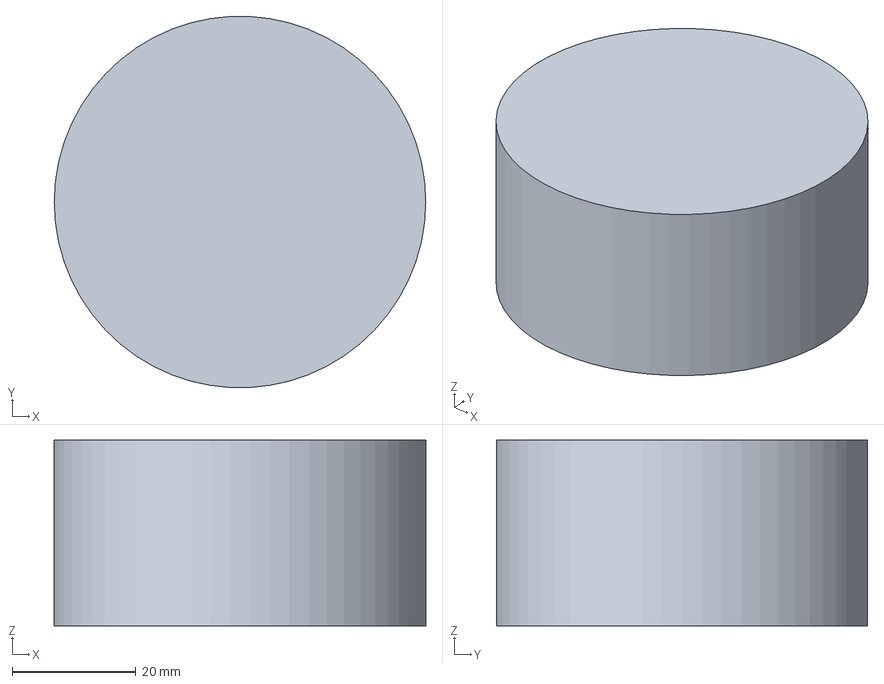
[picture p52: CAD file, 2026-10-23]
solidworks/pecas/VO-CO01_Mancal-tubo-torcao-E.step
60.0 x 59.9 x 30.0 mm
