marneierencio/cockpit-2dof/solidworks/pecas/SOLD-ARRASTO_D_Soldado-Tirante-Carro-D.step

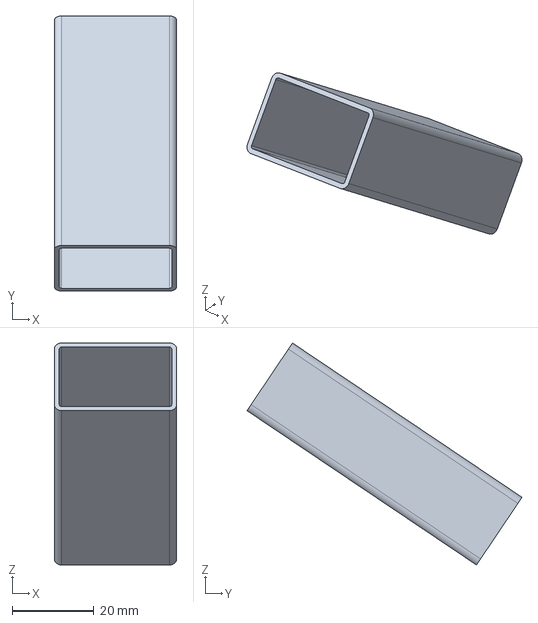
[picture p53: CAD file, 2026-10-23]
solidworks/pecas/SOLD-ARRASTO_D_Soldado-Tirante-Carro-D.step
30.0 x 67.5 x 54.4 mm
