marneierencio/cockpit-2dof/solidworks/pecas/BC-ES09_Aba-cabeca-E.step

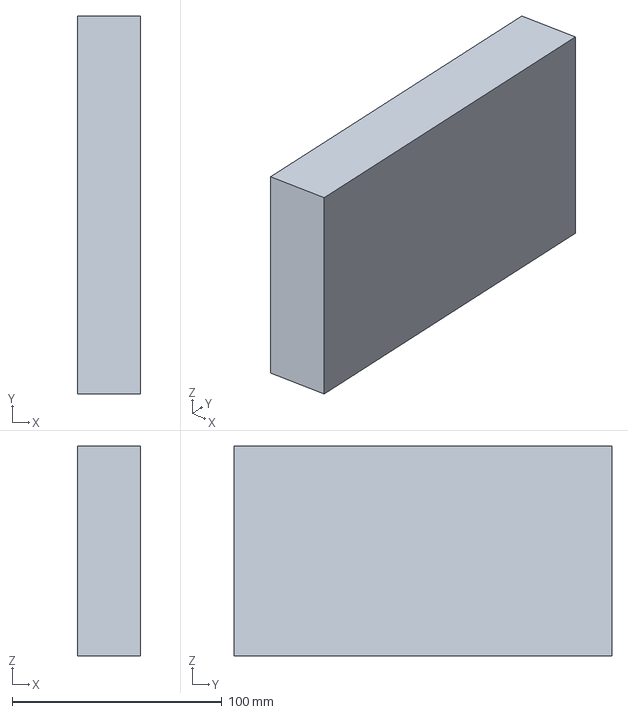
[picture p54: CAD file, 2026-10-23]
solidworks/pecas/BC-ES09_Aba-cabeca-E.step
30.0 x 180.0 x 100.0 mm
