marneierencio/cockpit-2dof/solidworks/pecas/BC-ES05_Aba-encosto-E.step

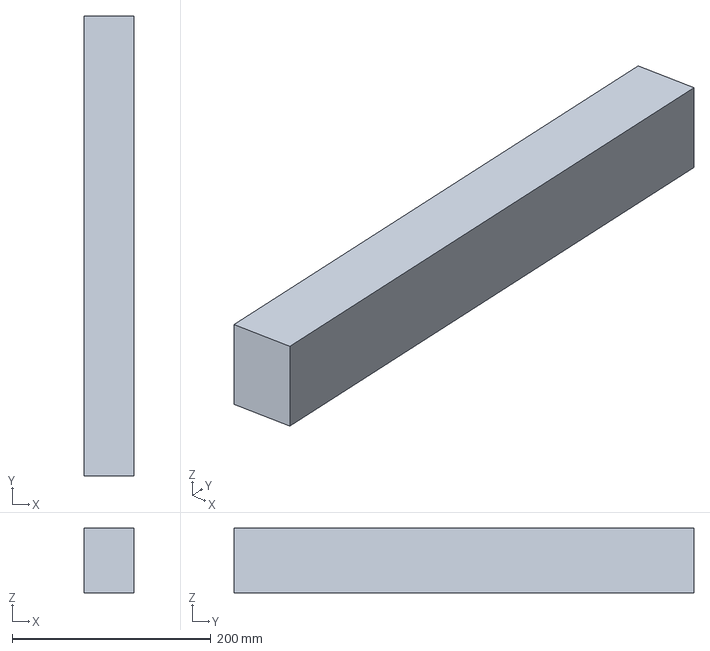
[picture p55: CAD file, 2026-10-23]
solidworks/pecas/BC-ES05_Aba-encosto-E.step
50.0 x 463.3 x 65.0 mm
