marneierencio/cockpit-2dof/solidworks/pecas/B-CO01_Junta-Cardan-BASE.step

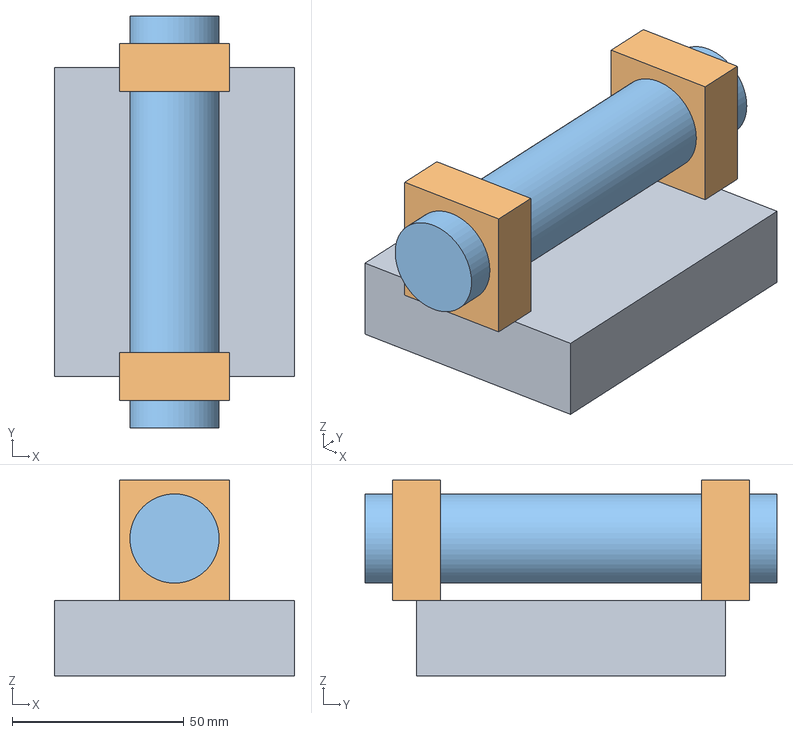
[picture p56: CAD file, 2026-10-23]
solidworks/pecas/B-CO01_Junta-Cardan-BASE.step
70.0 x 120.0 x 57.0 mm
