marneierencio/cockpit-2dof/solidworks/pecas/VO-CO03_G920-Volante-BRACO.step

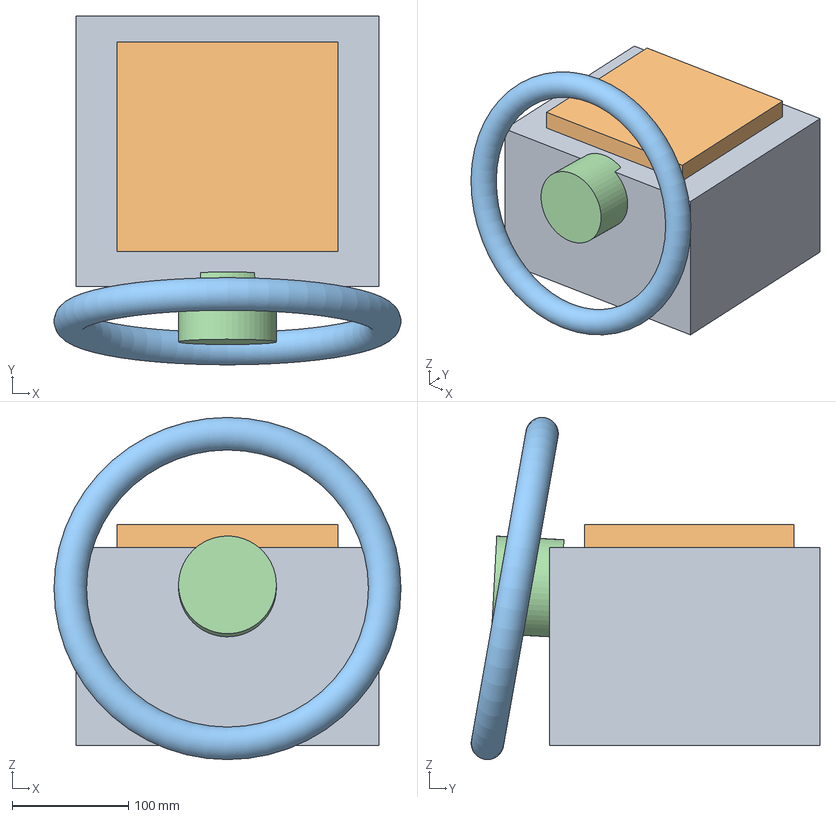
[picture p57: CAD file, 2026-10-23]
solidworks/pecas/VO-CO03_G920-Volante-BRACO.step
298.0 x 299.4 x 293.9 mm
