marneierencio/cockpit-2dof/solidworks/pecas/SOLD-HASTE_ASS_Soldado-Haste-Assento.step

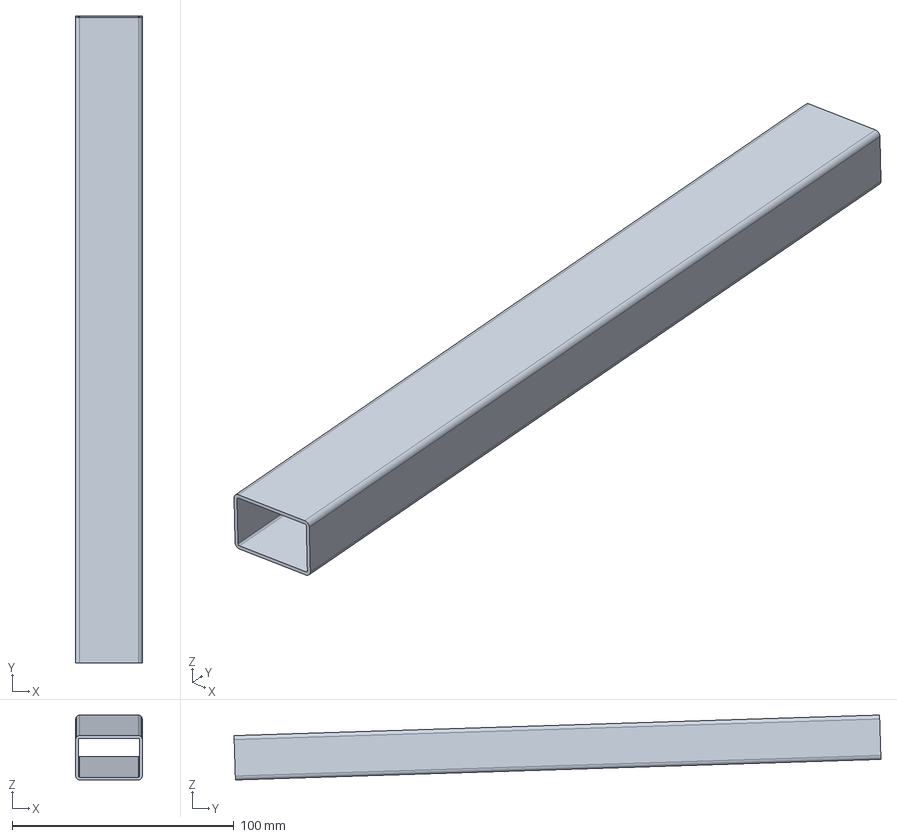
[picture p58: CAD file, 2026-10-23]
solidworks/pecas/SOLD-HASTE_ASS_Soldado-Haste-Assento.step
30.0 x 291.5 x 29.3 mm
