marneierencio/cockpit-2dof/solidworks/pecas/SOLD-DECK_Soldado-Pedaleira-Basculante.step

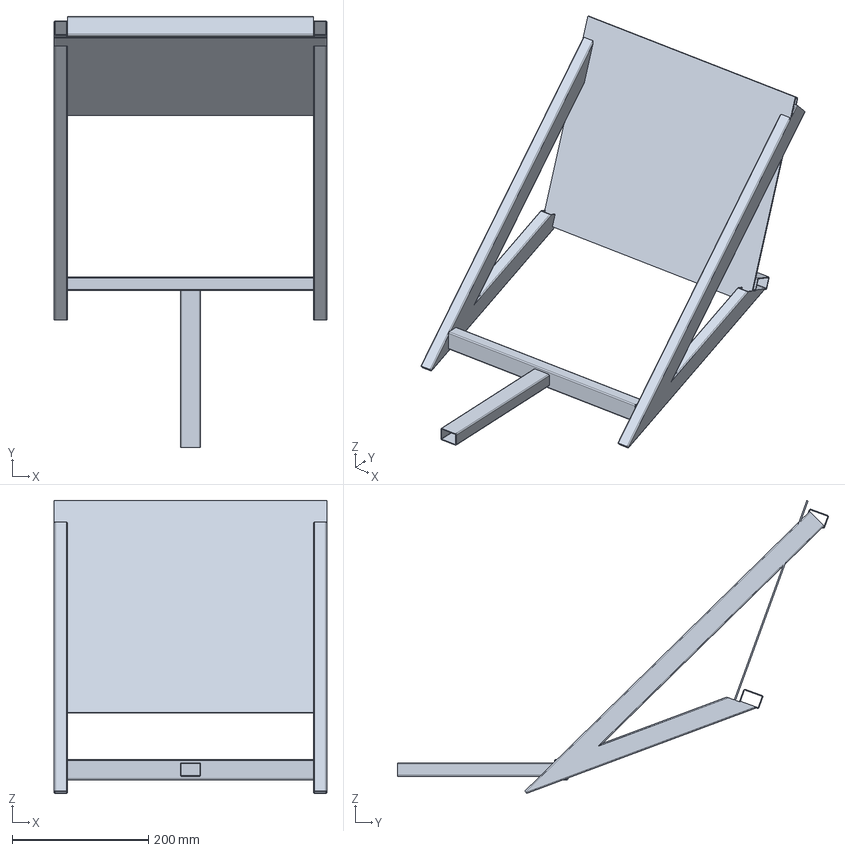
[picture p59: CAD file, 2026-10-23]
solidworks/pecas/SOLD-DECK_Soldado-Pedaleira-Basculante.step
400.0 x 631.7 x 429.5 mm
