marneierencio/cockpit-2dof/solidworks/pecas/B-CH04_Braco-manivela-10mm-E.step

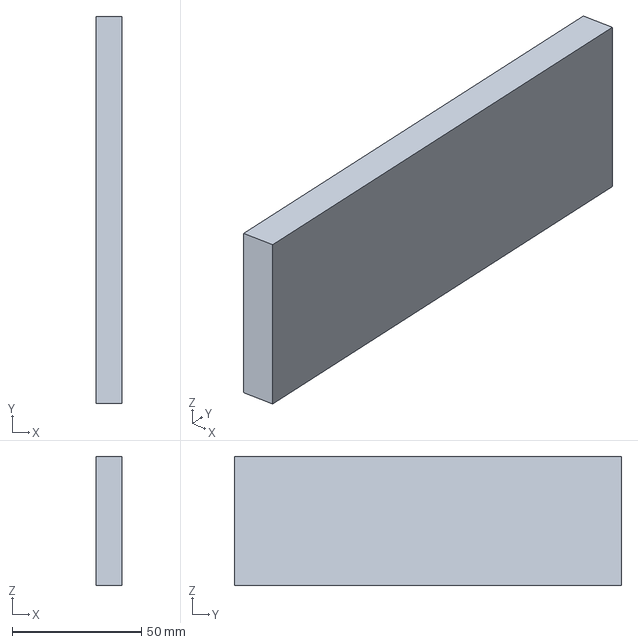
[picture p60: CAD file, 2026-10-23]
solidworks/pecas/B-CH04_Braco-manivela-10mm-E.step
10.0 x 150.0 x 50.0 mm
