marneierencio/cockpit-2dof/solidworks/pecas/PO-PI02_Trava-rapida-da-porta.step

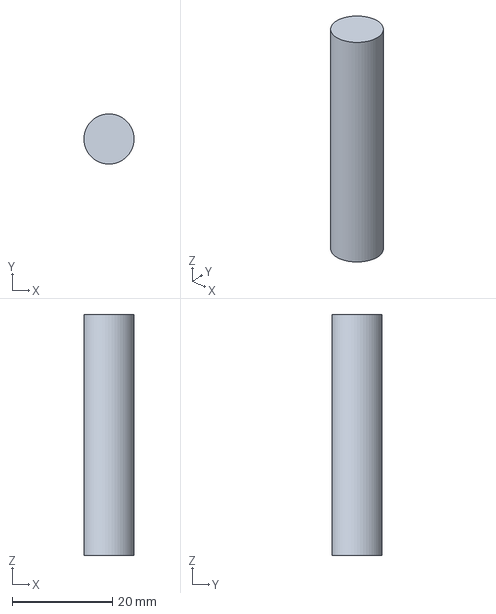
[picture p61: CAD file, 2026-10-23]
solidworks/pecas/PO-PI02_Trava-rapida-da-porta.step
9.99 x 10.00 x 48.0 mm
