marneierencio/cockpit-2dof/solidworks/pecas/SOLD-APOIO_Soldado-Encosto-Superior.step

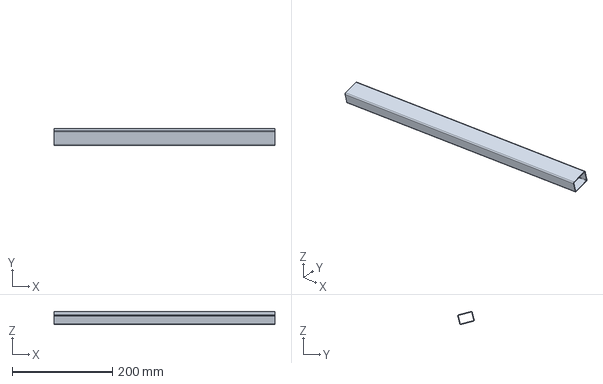
[picture p62: CAD file, 2026-10-23]
solidworks/pecas/SOLD-APOIO_Soldado-Encosto-Superior.step
440.0 x 33.3 x 26.3 mm
