marneierencio/cockpit-2dof/solidworks/pecas/SOLD-CARRO_Soldado-Carro-Banco.step

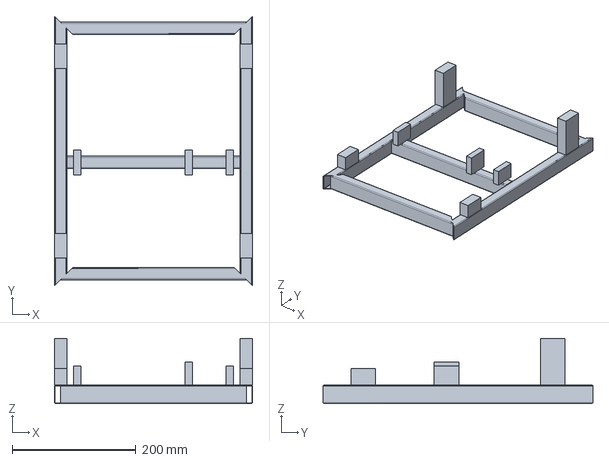
[picture p63: CAD file, 2026-10-23]
solidworks/pecas/SOLD-CARRO_Soldado-Carro-Banco.step
320.0 x 436.2 x 105.5 mm
