marneierencio/cockpit-2dof/solidworks/pecas/A-CO01_G920-Cambio-MOV.step

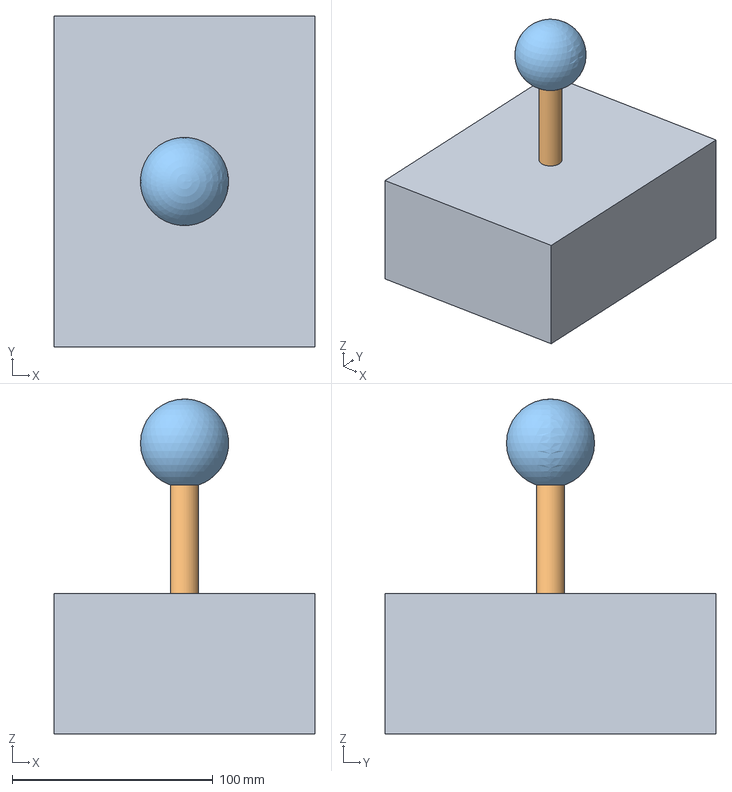
[picture p64: CAD file, 2026-10-23]
solidworks/pecas/A-CO01_G920-Cambio-MOV.step
130.0 x 165.0 x 167.0 mm
