marneierencio/cockpit-2dof/solidworks/pecas/SOLD-HASTE_PED_Soldado-Haste-Pedaleira.step

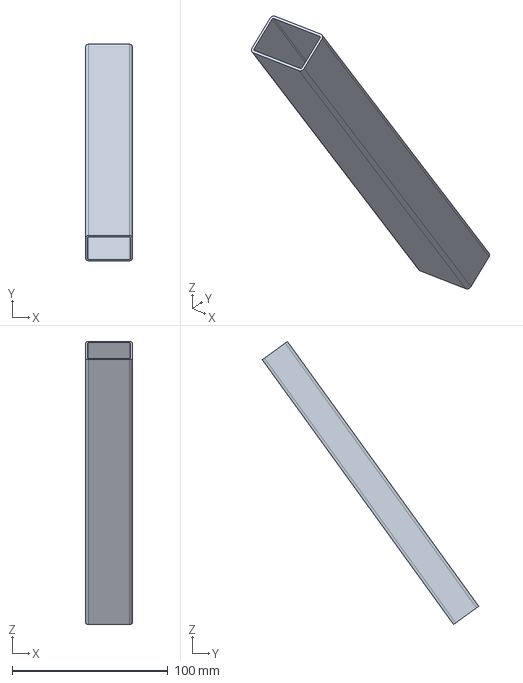
[picture p65: CAD file, 2026-10-23]
solidworks/pecas/SOLD-HASTE_PED_Soldado-Haste-Pedaleira.step
30.0 x 139.0 x 181.7 mm
