marneierencio/cockpit-2dof/solidworks/pecas/BC-CO02_Calco-borracha-apoio-F1-diant-E.step

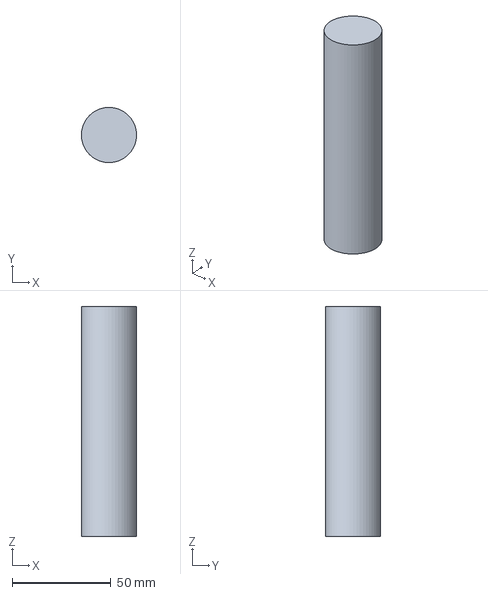
[picture p66: CAD file, 2026-10-23]
solidworks/pecas/BC-CO02_Calco-borracha-apoio-F1-diant-E.step
28.0 x 28.0 x 116.6 mm
