marneierencio/cockpit-2dof/solidworks/pecas/SOLD-PORTA_Soldado-Porta-Barra.step

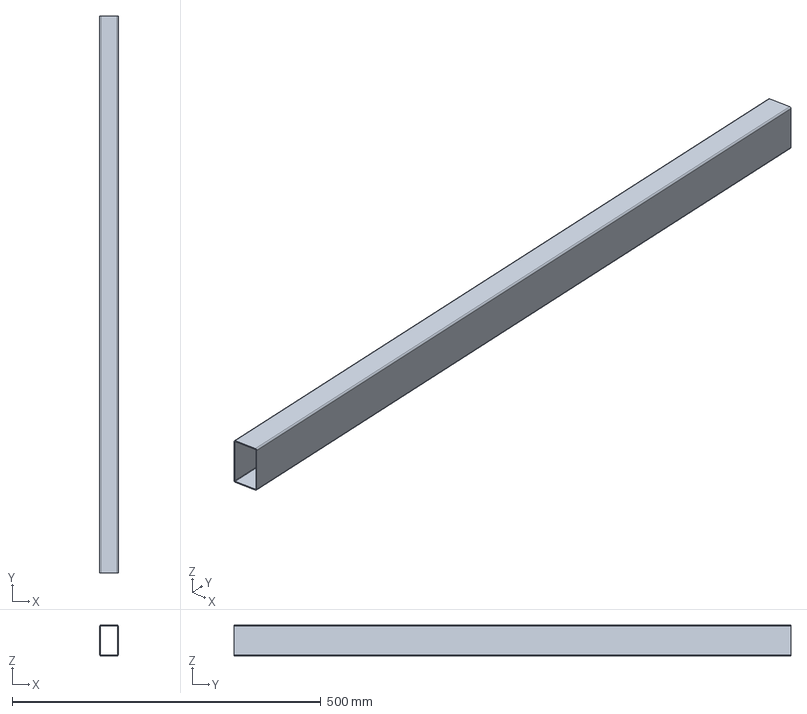
[picture p67: CAD file, 2026-10-23]
solidworks/pecas/SOLD-PORTA_Soldado-Porta-Barra.step
30.0 x 902.3 x 50.0 mm
