marneierencio/cockpit-2dof/(list of files, cad)

Other CAD files:
solidworks/pecas/BC-CH05_Orelha-tirante-subchassi-E-chapa-sem-tubo-de-apo.step
solidworks/pecas/BC-PI17_Pino-tirante-arrasto-na-biela-E.step
solidworks/pecas/SOLD-BANCO-2_Soldado-Banco-2.step
solidworks/pecas/VO-CH09_Chapa-came-volante-4mm-D-chapa-sem-tubo-de-apoio.step
solidworks/pecas/SOLD-BIELA_D_Diant_Soldado-Biela-Banco-D-Diant.step
solidworks/pecas/BC-CH09_Alavanca-encosto-E-chapa-12x70-chapa-sem-tubo-de.step
solidworks/pecas/SOLD-HASTE_ENC_D_Soldado-Haste-Encosto-D.step
solidworks/pecas/SOLD-BIELA_E_Tras_Soldado-Biela-Banco-E-Tras.step
solidworks/pecas/SOLD-MASTRO-2_Soldado-Mastro-Volante-2.step
solidworks/pecas/SOLD-BIELA_E_Diant_Soldado-Biela-Banco-E-Diant.step
solidworks/pecas/SOLD-BRACO-3_Soldado-Braco-Volante-3.step
solidworks/pecas/SOLD-ARRASTO_E_Soldado-Tirante-Carro-E.step
solidworks/pecas/SOLD-TIRANTE_E_Soldado-Tirante-Apoio-E.step
solidworks/pecas/BC-CH08_Orelha-tirante-apoio-D-chapa-sem-tubo-de-apoio.step
modelo/cockpit_simulador_F1_caminhao (1).skp
modelo/cockpit_simulador_F1_caminhao.skp
modelo/preview_juntas_soleira.skp
modelo/preview_v3leve_porta.skp
modelo/v3_F1.skp
modelo/v3_caminhao.skp
modelo/v3_porta_aberta.skp
modelo/v3_transicao.skp
