marneierencio/cockpit-2dof/(commit log)

2026-10-21 Add parametric SketchUp model, design memorial and previews
    - modelo/gerar_modelo.py: parametric generator for the 2-DOF cockpit
    (fixed base, cardan pivot, stepper crank actuators, moving platform,
    adjustable seat/pedals/wheel, articulated 1.73 m mannequin) with F1
    and truck postures, tags and scenes
    - docs/MEMORIAL-DESCRITIVO.md: detailed design memorial (PT-BR)
    - imagens/: model previews for both configurations
    - README with overview and regeneration instructions
    Claude-Session: https://claude.ai/code/session_01DWD6bwpefCeaaesNo8KcJj
2026-10-22 Adjustable mechanisms, G920 peripherals and ANIMATE dynamic components (v2)
    - One cockpit instead of two overlaid configurations: four-bar seat with
    reclining back, tilting pedal deck and pivoting steering arm, each on a
    rail carriage with pin locks; pivots and travel solved so one rotation
    plus one slide maps the F1 pose exactly onto the truck pose
    - Logitech G920 wheel/pedals and Driving Force Shifter modelled from the
    published overall dimensions as swappable components
    - Moving parts are Dynamic Components driven by Plataforma_Movel 'modo';
    OnClick runs ANIMATE("modo",0,1), with a 'sentido' switch to flip the
    rotation convention if needed
    - Truck posture adjusted (hip +60 mm,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
2026-10-22 Tilting seat pan and clavicle-hinged shoulder/head support (R2)
    - Seat split into a level sub-frame carried by the parallelogram, a pan
    hinged at C (25 deg in F1, parallel to the thigh; 9 deg in the truck)
    and a two-segment back: lumbar segment reclines, upper shoulder/head
    segment hinges at clavicle height and counter-rotates so it always
    sits at the truck back angle (75 deg), giving a racing-shell effect
    - F1 head now rests on the upper segment; truck pose unchanged apart
    from the taller back
    - Generator reports F1 seat clearances (head 7 mm, shoulders 26 mm,
    pan/link 9 mm, thigh cushion 29 mm)
    - Design memorial revised to R2; README and previews updated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
2026-10-22 v3 (R3): ring frame, upward door bar, one-movement conversion, calculations, BOM and cut plan
    - Generator refactored into a pure-Python model (part registry with IDs,
    node kinematics, mass properties, automatic CG balancing) plus an
    EMIT-gated SketchUp layer; PRESET block keeps the SketchUp run under 30 s
    - Ring frame at ZP+550 with side trusses, lowered rear cross, upward-opening
    door bar (own DC attribute `aberta`), shifter fixed on the ring
    - Left sill truss, triple 30x50 pivot cross + 16 mm plate, 12 mm crank plates
    - One-movement modules: seat drag links, pan rod, paired back rods, headrest
    parallel tie rod, F1 rest pads; pedal rod; steering cam; ball-lock pins
    - DC motion laws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
    [lista_de_materiais.csv, plano_de_corte.csv]
2026-10-22 v3-leve: structure reduced from 179 to 136 kg (moving 130 -> 98 kg)
    - 20x30 tube wall 2.0 -> 1.2 mm; door bar in 30x50 (20x30x1.2 failed the
    600 N lean-on check)
    - ring reduced to a guide rail: 4 posts per side, diagonals only in the
    two bays around the pivot and in the rear left bay
    - base with 8 crossmembers; thinner plates (pivot 8 mm doubler on the
    three crosses, tower top 8 mm, crank 10 mm, cams 4 mm, pedal plate 2 mm)
    - seat segments: one 20x30 spine on the plywood board instead of a frame
    - design rod force limited to 1.8 kN at the driver (cyclic need 1.1 kN)
    - docs regenerated; memorial and README updated with the new figures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
    [lista_de_materiais.csv, plano_de_corte.csv]
2026-10-23 Fix tube joints, add STE report v2 and SolidWorks export
    - generator: resolve every tube end into a mitre, a butt on the host face or a
    square cut; the SketchUp drawing now emits each tube as a hexahedron through
    the 8 cut corners (no sticking corner caps, V joints mitred, no crossings)
    - layout fixes the joint rule needs: sill truss with 2 uprights + 1 diagonal,
    ring and end-frame diagonals landing on column faces, floor diagonals on the
    cross tubes, flush rails, extra base cross tube and motor-plate rails
    - ferramentas/cad.py: OpenCascade hollow-tube solids and the joint gate
    (0 overlaps inside a weldment)
    - ferramentas/exportar_cad.py + solidworks/: one STEP per distinct part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
    [A-CO01_G920-Cambio-MOV.step, B-CH04_Braco-manivela-10mm-E.step, B-CO01_Junta-Cardan-BASE.step, B-CO05_Redutor-planetario-E.step, B-CO06_Motor-de-passo-NEMA-34-E.step, B-CO07_Terminal-rotular-inferior-E.step, B-CO11_Batente-borracha-E.step, B-PI01_Eixo-saida-redutor-E.step]
